irfxn-r/Active-Dampers/Master/jlcpcb/production_files/BOM-Active-Damper-Master.csv

Comment | Designator | Footprint | LCSC | Quantity
100k | R13,R3 | C_0603_1608Metric | C25803 | 2
100nF | C14,C19,C20 | C_0603_1608Metric | C14663 | 3
100pF | C54,C56,C57,C58 | C_0603_1608Metric | C14858 | 4
10k | R10 | R_0805_2012Metric | C17414 | 1
10nF | C9 | C_0603_1608Metric | C57112 | 1
10uF | C2,C21,C22 | C_0603_1608Metric | C96446 | 3
15uH | L1 | Inductor_7.3x6.6mm | C2045384 | 1
18k | R14,R8 | C_0603_1608Metric | C22967 | 2
1k | R23,R38 | R_0603_1608Metric | C21190 | 2
1uF | C1,C24,C25 | C_0603_1608Metric | C15849 | 3
2.2k | R12,R15 | C_0603_1608Metric | C4190 | 2
22nF | C4,C5,C6,C7,C8 | C_0603_1608Metric | C21122 | 5
22uF | C11,C12,C13,C15,C16,C17,C18 | C_0603_1608Metric | C59461 | 7
2k | R9 | R_0603_1608Metric | C22975 | 1
3.24k | R11 | R_0805_2012Metric | C26010 | 1
4.7k | R51,R54 | R_0603_1608Metric | C23162 | 2
5k1 | R6,R7 | R_0603_1608Metric | C23186 | 2
60 | R46,R47,R48,R49 | C_0603_1608Metric | C25196 | 4
68nF | C48,C49 | C_0603_1608Metric | C31658 | 2
AMS1117-3.3 | U3 | SOT-223-3_TabPin2 | C6186 | 1
ESP32-C6-WROOM-1-N8 | IC1 | ESP32C6WROOM1N8 | C5366877 | 1
LED BLUE | D7 | LED_0603_1608Metric | C2286 | 1
PESD1CAN | D6,D8 | SOT-23 | C15771 | 2
SS54 | D10,D2,D9 | D_SMA | C22452 | 3
SW_SPST | SW2,SW3 | SW_SPST_TS-1088-xR025 | C720477 | 2
TPS5430DDAR | U2 | ESOP-8_L4.9-W3.9-P1.27-LS6.0-TL-EP | C9864 | 1
USB_C_Receptacle_USB2.0_16P | J6 | USB_C_Receptacle_HRO_TYPE-C-31-M-12 | C165948 | 1
LSM6DSL | U6 | LGA-14_3x2.5mm_P0.5mm_LayoutBorder3x4y |  | 1
SN65HVD230 | U4 | SOIC-8_3.9x4.9mm_P1.27mm |  | 1
SN65HVD230 | U5 | SOIC-8_3.9x4.9mm_P1.27mm |  | 1
Conn_01x08 | J2 | JST_VH_B8P-VH-B_1x08_P3.96mm_Vertical |  | 1
