irfxn-r/Active-Dampers/Slave/jlcpcb/production_files/BOM-Active-Damper-Slave.csv

Comment | Designator | Footprint | LCSC | Quantity
0.1 | R4,R5 | C_2010_5025Metric_Pad1.52x2.65mm | C17903 | 2
100k | R3 | R_0402_1005Metric | C21190 | 1
100nF | C1,C14,C26 | C_0402_1005Metric | C14663 | 3
100pF | C57,C58,C59,C60 | C_0402_1005Metric | C14858 | 4
10k | R10,R2 | R_0402_1005Metric | C25744 | 2
10nF | C9 | C_0603_1608Metric | C57112 | 1
10uF | C10,C28 | C_0402_1005Metric | C15525 | 2
15uH | L1 | Inductor_7.3x6.6mm | C2045384 | 1
1k | R1 | R_0402_1005Metric | C11702 | 1
1uF | C19,C20,C21,C23,C24,C25,C27 | C_0402_1005Metric | C52923 | 7
2.2uF | C31 | C_0402_1005Metric | C12530 | 1
22nF | C22,C30,C4,C5,C6,C7,C8 | C_0603_1608Metric | C21122 | 7
22pF | C2,C29 | C_0402_1005Metric | C1555 | 2
22uF | C11,C12,C13,C15,C16,C17,C18 | C_0402_1005Metric | C59461 | 7
3.24k | R11 | R_0603_1608Metric | C22978 | 1
4.7k | R51,R53,R54 | R_0402_1005Metric | C25900 | 3
5k1 | R6,R7 | R_0603_1608Metric | C23186 | 2
60 | R48,R49,R52,R55 | C_0603_1608Metric | C23204 | 4
AMS1117-3.3 | U3 | SOT-223-3_TabPin2 | C6186 | 1
B5819WS | D5 | D_SOD-323 | C64886 | 1
LIS3DH | U4 | LGA-16_3x3mm_P0.5mm_LayoutBorder3x5y | C15134 | 1
PESD1CAN | D11,D8 | SOT-23 | C15771 | 2
SS54 | D2 | D_SMA | C22452 | 1
STM32F103C8T6 | U1 | LQFP-48_7x7mm_P0.5mm | C8734 | 1
SW_SPST | SW1 | SW_SPST_TS-1088-xR025 | C720477 | 1
TMC2209-LA | U5 | VQFN-28-1EP_5x5mm_P0.5mm_EP3.7x3.7mm_ThermalVias | C2150710 | 1
TPS5430DDAR | U2 | ESOP-8_L4.9-W3.9-P1.27-LS6.0-TL-EP | C9864 | 1
USB_C_Receptacle_USB2.0_16P | J6 | USB_C_Receptacle_HRO_TYPE-C-31-M-12 | C165948 | 1
X50328MSB2GI | X1 | CRYSTAL-SMD_L5.0-W3.2 | C115962 | 1
CAN_2 | J8 | JST_PH_S3B-PH-K_1x03_P2.00mm_Horizontal |  | 1
ATA6563-GBQW1 | IC4 | SON65P300X300X90-9N-D |  | 1
POWER | J7 | JST_PH_S3B-PH-K_1x03_P2.00mm_Horizontal |  | 1
ATA6563-GBQW1 | IC3 | SON65P300X300X90-9N-D |  | 1
CAN_1 | J9 | JST_PH_S3B-PH-K_1x03_P2.00mm_Horizontal |  | 1
AS5600-ASOM | IC2 | SOIC127P600X175-8N |  | 1
SHF-105-01-F-D-TH | J3 | SHF10501FDTH |  | 1
