irfxn-r/Active-Dampers/Slave/CAD/Slave.step

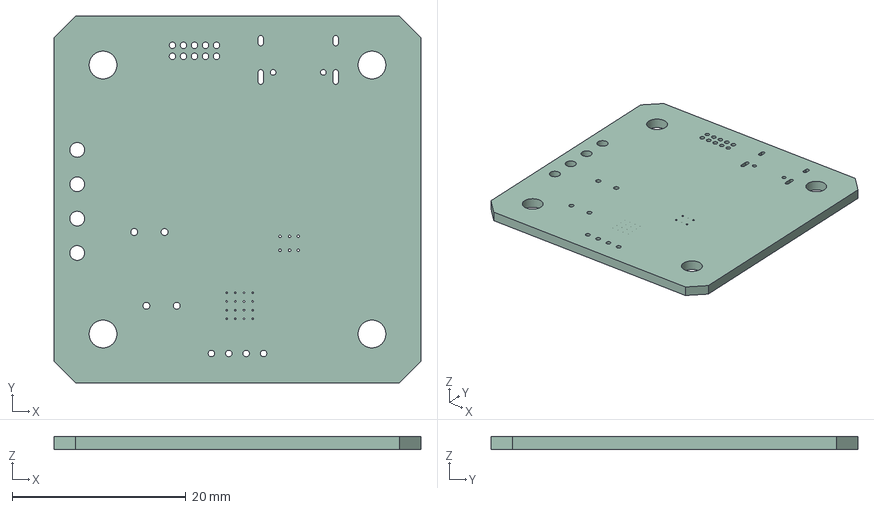
[picture p1: CAD file, 2026-09-19]
Slave/CAD/Slave.step
42.3 x 42.3 x 1.51 mm
