irfxn-r/Active-Dampers/(list of files, drawings)

Other design files:
Daughter/imu_daughter_board backup/sch_data.json
