irfxn-r/Active-Dampers/Master/Active-Damper-Master.kicad_pcb

## KiCad design Master/Active-Damper-Master.kicad_pcb (2026-09-27)

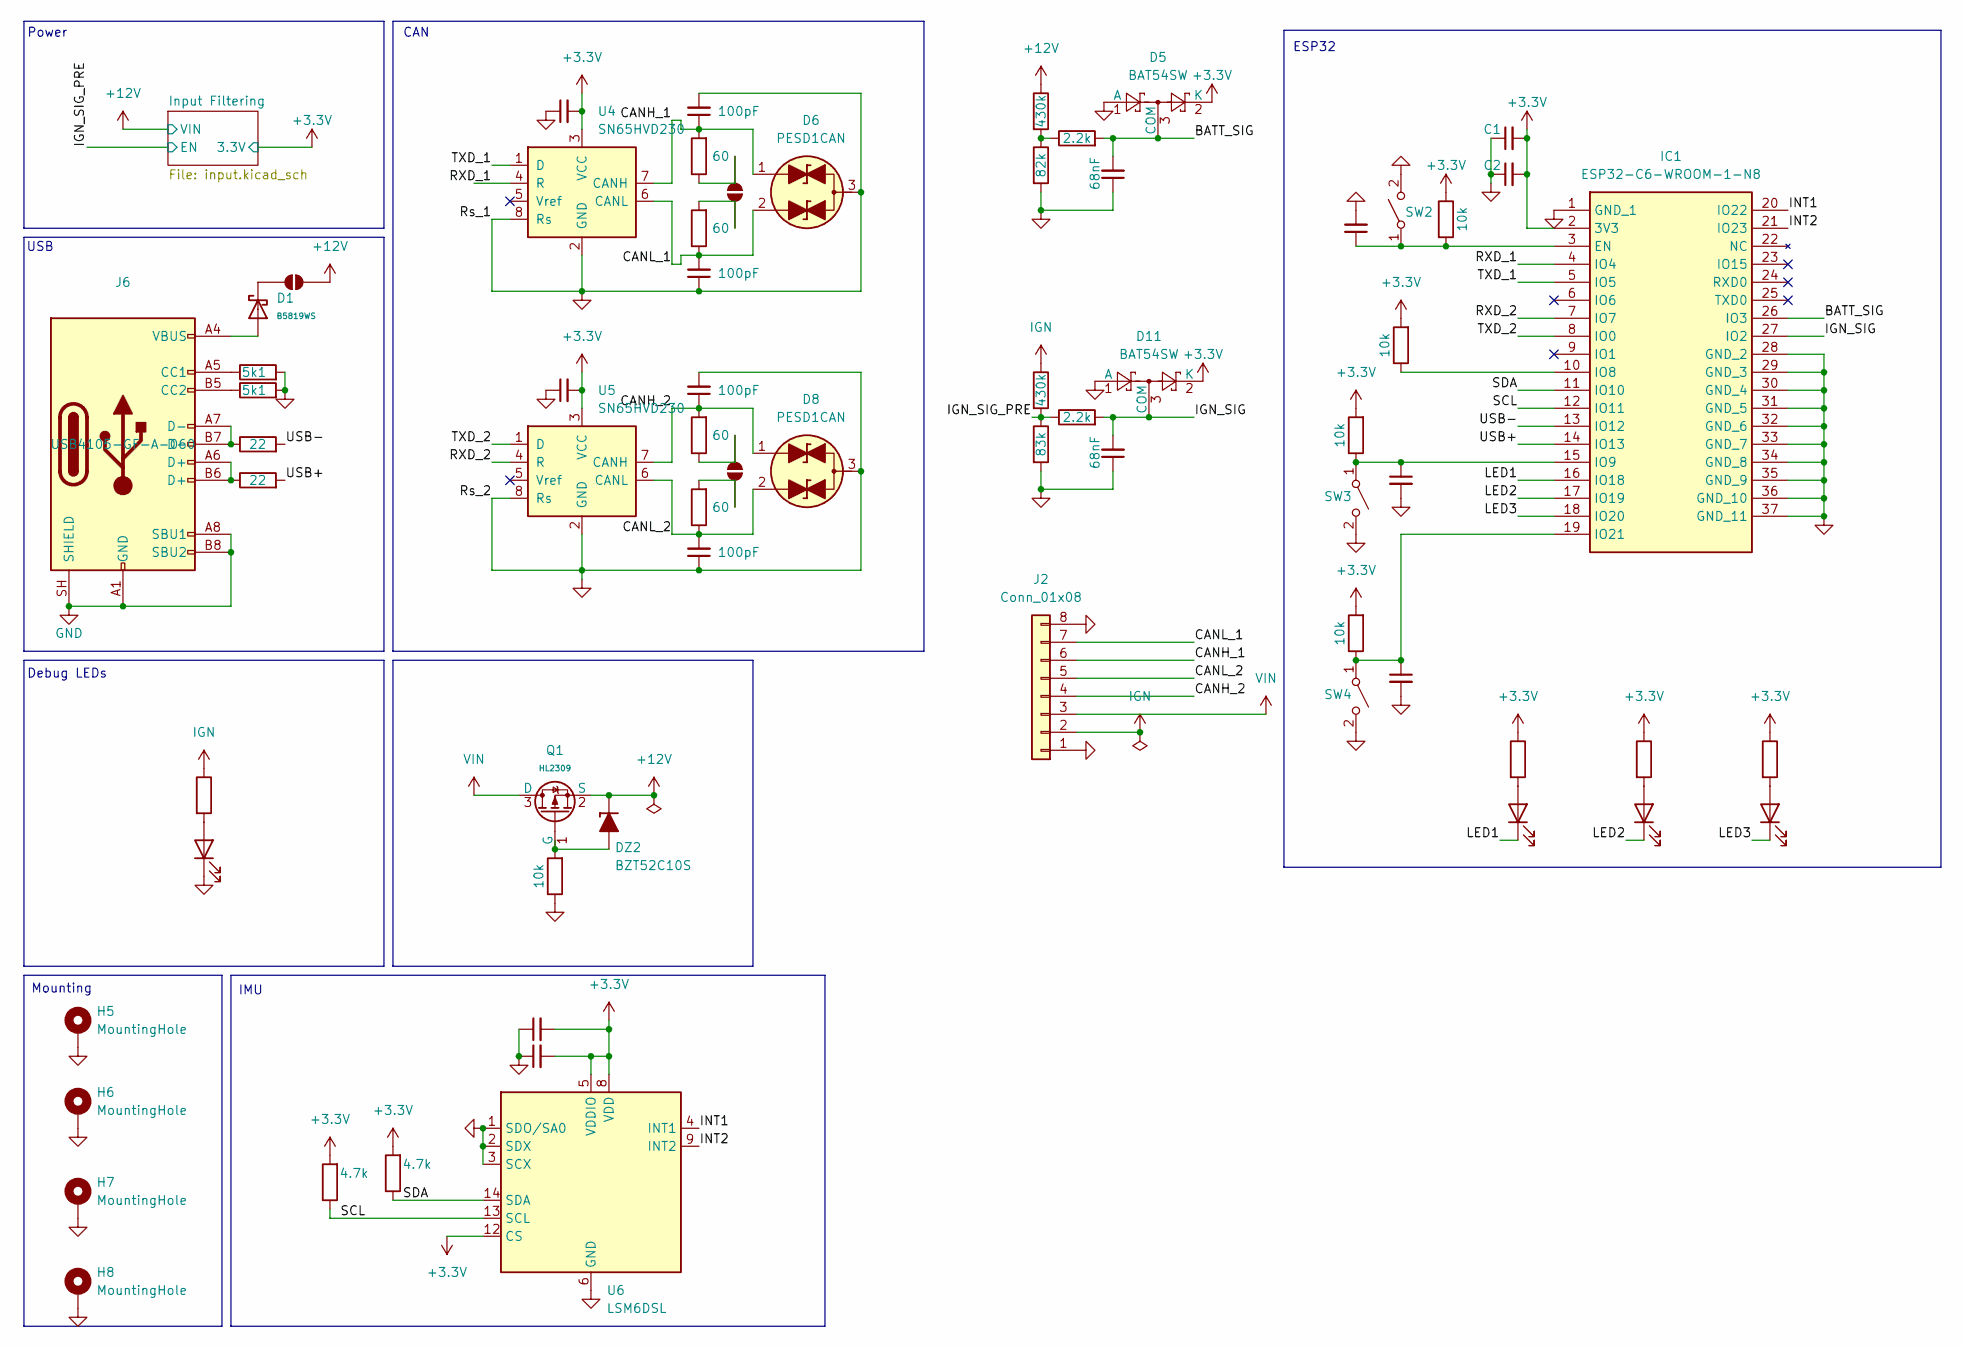
[picture p2: schematic Active-Damper-Master.kicad_sch]

Parts:
C1, C24, C25: 1uF; C_0603_1608Metric; Manufacturer_Part_Number TMK105BJ105MV-F; LCSC C15849
C2, C21, C26: 10uF; C_0603_1608Metric; Manufacturer_Part_Number CL05A106MP5NUNC; LCSC C96446
C19, C20: 100nF; C_0603_1608Metric; Manufacturer_Part_Number TMK105BJ105MV-F; LCSC C15849
C22: 1uF; C_0603_1608Metric; Manufacturer_Part_Number CL05A106MP5NUNC; LCSC C96446
C48, C49: 68nF; C_0603_1608Metric; Manufacturer_Part_Number CC0402KRX7R9BB683; LCSC C31658
C54, C56, C57, C58: 100pF; C_0603_1608Metric; LCSC C14858
D1: B5819WS; D_SOD-323; Forward Voltage (Vf@If) 900mV@3A; Reverse Voltage (Vr) 40V; Part B5819WS; LCSC C64886
D5, D11: BAT54SW; SOT-323_SC-70
D6, D8: PESD1CAN; SOT-23; LCSC C15771
D7, D9, D10, D12: LED BLUE; LED_0603_1608Metric; Manufacturer_Part_Number VLMB1500-GS08; LCSC C2286
DZ2: BZT52C10S; D_SOD-323
H5, H6, H7, H8: MountingHole; MountingHole_3.2mm_M3_ISO14580_Pad_TopBottom
IC1: ESP32-C6-WROOM-1-N8; ESP32C6WROOM1N8; Mouser Part Number 356-ESP32C6WROOM1N8
J2: Conn_01x08; JST_VH_B8P-VH-B_1x08_P3.96mm_Vertical
J6: USB_C_Receptacle_USB2.0_16P; USB_C_Receptacle_HRO_TYPE-C-31-M-12; Manufacturer_Part_Number USB4105-GF-A-060; LCSC C165948
JP2, JP4: SolderJumper_2_Open; SolderJumper-2_P1.3mm_Open_RoundedPad1.0x1.5mm
JP3: SolderJumper_2_Open; SolderJumper-2_P1.3mm_Open_Pad1.0x1.5mm
Q1: HL2309; SOT-23; Part HL2309; LCSC C28646263
R3, R13: 430k; C_0603_1608Metric; Manufacturer_Part_Number RC0402FR-07150KL; LCSC C25803
R6, R7: 5k1; R_0603_1608Metric; Manufacturer_Part_Number RC0402FR-071KL; LCSC C23186
R8: 82k; C_0603_1608Metric; Manufacturer_Part_Number AC0402JR-7D10KL; LCSC C22967
R9: 4..7k; R_0603_1608Metric; Manufacturer_Part_Number CR0402-FX-5101GLF; LCSC C22975
R12, R15: 2.2k; C_0603_1608Metric; Manufacturer_Part_Number RC0402FR-072K2L; LCSC C4190
R14: 83k; C_0603_1608Metric; Manufacturer_Part_Number AC0402JR-7D10KL; LCSC C22967
R16, R17, R18: 1k; R_0603_1608Metric; Manufacturer_Part_Number CR0402-FX-5101GLF; LCSC C22975
R19, R20: 22; R_0402_1005Metric; Manufacturer_Part_Number RC0402FR-071KL; LCSC C23186
R23, R38, R39, R40, R41: 10k; R_0603_1608Metric; Manufacturer_Part_Number RC0402FR-071KL; LCSC C21190
R46, R47, R48, R49: 60; C_0603_1608Metric; LCSC C25196
R51, R54: 4.7k; R_0603_1608Metric; LCSC C23162
SW2, SW3, SW4: SW_SPST; SW_SPST_TS-1088-xR025; LCSC C720477
U4, U5: SN65HVD230; SOIC-8_3.9x4.9mm_P1.27mm
U6: LSM6DSL; LGA-14_3x2.5mm_P0.5mm_LayoutBorder3x4y

Connections:
+3.3V: C1.2, C2.2, C19.2, C20.2, C24.2, C25.2, D5.2 (K), D11.2 (K), IC1.2 (3V3), R16.1, R17.1, R18.1, R23.1, R38.2, R40.2, R41.2, R51.2, R54.2, U4.3 (VCC), U5.3 (VCC), U6.5 (VDDIO), U6.8 (VDD), U6.12 (CS)
+12V: DZ2.1 (K), JP3.2 (B), Q1.2 (S), R3.1; also elsewhere on the board
/BATT_SIG: C48.2, D5.3 (COM), IC1.26 (IO3), R12.2
/CANH_1: C56.1, D6.1 (A1), J2.6, R46.2, U4.7 (CANH)
/CANH_2: C57.1, D8.1 (A1), J2.4, R48.2, U5.7 (CANH)
/CANL_1: C54.2, D6.2 (A2), J2.7, R47.1, U4.6 (CANL)
/CANL_2: C58.2, D8.2 (A2), J2.5, R49.1, U5.6 (CANL)
/IGN_SIG: C49.2, D11.3 (COM), IC1.27 (IO2), R15.2
/IGN_SIG_PRE: R13.2, R14.1, R15.1; also elsewhere on the board
/INT1: IC1.20 (IO22), U6.4 (INT1)
/INT2: IC1.21 (IO23), U6.9 (INT2)
/LED1: D9.1 (K), IC1.16 (IO18)
/LED2: D10.1 (K), IC1.17 (IO19)
/LED3: D12.1 (K), IC1.18 (IO20)
/RXD_1: IC1.4 (IO4), U4.4 (R)
/RXD_2: IC1.7 (IO7), U5.4 (R)
/SCL: IC1.12 (IO11), R54.1, U6.13 (SCL)
/SDA: IC1.11 (IO10), R51.1, U6.14 (SDA)
/TXD_1: IC1.5 (IO5), U4.1 (D)
/TXD_2: IC1.8 (IO0), U5.1 (D)
/USB+: IC1.14 (IO13), R20.2
/USB-: IC1.13 (IO12), R19.2
GND: C1.1, C2.1, C19.1, C20.1, C21.2, C22.2, C24.1, C25.1, C26.2, C48.1, C49.1, C54.1, C56.2, C57.2, C58.1, D5.1 (A), D6.3 (Com), D7.1 (K), D8.3 (Com), D11.1 (A), H5.1 (1_1), H6.1 (1_1), H7.1 (1_1), H8.1 (1_1), IC1.1 (GND_1), IC1.28 (GND_2), IC1.29 (GND_3), IC1.30 (GND_4), IC1.31 (GND_5), IC1.32 (GND_6), IC1.33 (GND_7), IC1.34 (GND_8), IC1.35 (GND_9), IC1.36 (GND_10), IC1.37 (GND_11), J2.1, J2.8, J6.A1 (GND), J6.A8 (SBU1), J6.A12 (GND), J6.B1 (GND), J6.B8 (SBU2), J6.B12 (GND), J6.SH (SHIELD), R6.2, R7.2, R8.2, R14.2, R39.1, SW2.2 (B), SW3.2 (B), SW4.2 (B), U4.2 (GND), U4.8 (Rs), U5.2 (GND), U5.8 (Rs), U6.1 (SDO/SA0), U6.2 (SDX), U6.3 (SCX), U6.6 (GND), U6.7 (GND); also elsewhere on the board
IGN: J2.2, R9.1, R13.1
unnamed: D1.2, J6.A4 (VBUS), J6.A9 (VBUS), J6.B4 (VBUS), J6.B9 (VBUS)
unnamed: D7.2 (A), R9.2
unnamed: D9.2 (A), R16.2
unnamed: D10.2 (A), R17.2
unnamed: D12.2 (A), R18.2
unnamed: DZ2.2 (A), Q1.1 (G), R39.2
unnamed: C22.1, IC1.3 (EN), R23.2, SW2.1 (A)
unnamed: IC1.10 (IO8), R41.1
unnamed: C21.1, IC1.15 (IO9), R38.1, SW3.1 (A)
unnamed: C26.1, IC1.19 (IO21), R40.1, SW4.1 (A)
unnamed: J6.A5 (CC1), R6.1
unnamed: J6.B5 (CC2), R7.1
unnamed: J6.A6 (D+), J6.B6 (D+), R20.1
unnamed: J6.A7 (D-), J6.B7 (D-), R19.1
unnamed: JP2.1 (A), R49.2
unnamed: JP2.2 (B), R48.1
unnamed: D1.1, JP3.1 (A)
unnamed: JP4.1 (A), R47.2
unnamed: JP4.2 (B), R46.1
unnamed: R3.2, R8.1, R12.1
VIN: J2.3, Q1.3 (D)

Notes on the sheet:
ESP32
IMU
CAN
Power
USB
Debug LEDs
Mounting

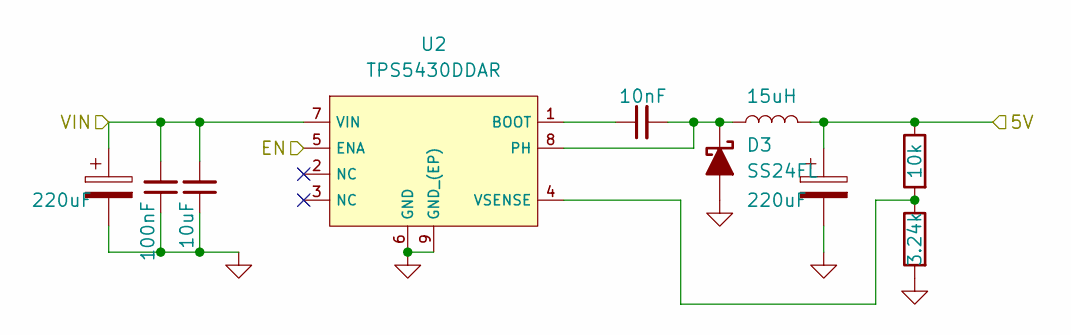
[picture p3: schematic input.kicad_sch]

Parts:
C3, C10: 220uF; CP_Radial_D8.0mm_P3.50mm
C9: 10nF; C_0603_1608Metric; Manufacturer_Part_Number GRM155R60J226ME11D; LCSC C57112
C34: 100nF; C_0603_1608Metric; Manufacturer_Part_Number CL05A106MP5NUNC; LCSC C21122
C35: 10uF; C_0603_1608Metric; Manufacturer_Part_Number CL05A106MP5NUNC; LCSC C21122
D3: SS24FL; D_SOD-123F
L1: 15uH; L_Taiyo-Yuden_NR-40xx; Manufacturer_Part_Number SLO0630H150MTT; LCSC C2045384
R21: 10k; R_0603_1608Metric; Manufacturer_Part_Number RC0402FR-0710KL; LCSC C25804
R22: 3.24k; R_0603_1608Metric; Manufacturer_Part_Number RC0402FR-0710KL; LCSC C22978
U2: TPS5430DDAR; ESOP-8_L4.9-W3.9-P1.27-LS6.0-TL-EP; Output Voltage 1.221V~32.04V; Input Voltage 5.5V~36V; Part TPS5430DDAR; LCSC C9864

Connections:
+12V: C3.1, C34.2, C35.2, U2.7 (VIN); also elsewhere on the board
/IGN_SIG_PRE: U2.5 (ENA); also elsewhere on the board
/Input Filtering/5V: C10.1, L1.2, R21.2
GND: C3.2, C10.2, C34.1, C35.1, D3.2 (A), R22.1, U2.6 (GND), U2.9 (GND_(EP)); also elsewhere on the board
unnamed: C9.2, D3.1 (K), L1.1, U2.8 (PH)
unnamed: C9.1, U2.1 (BOOT)
unnamed: R21.1, R22.2, U2.4 (VSENSE)

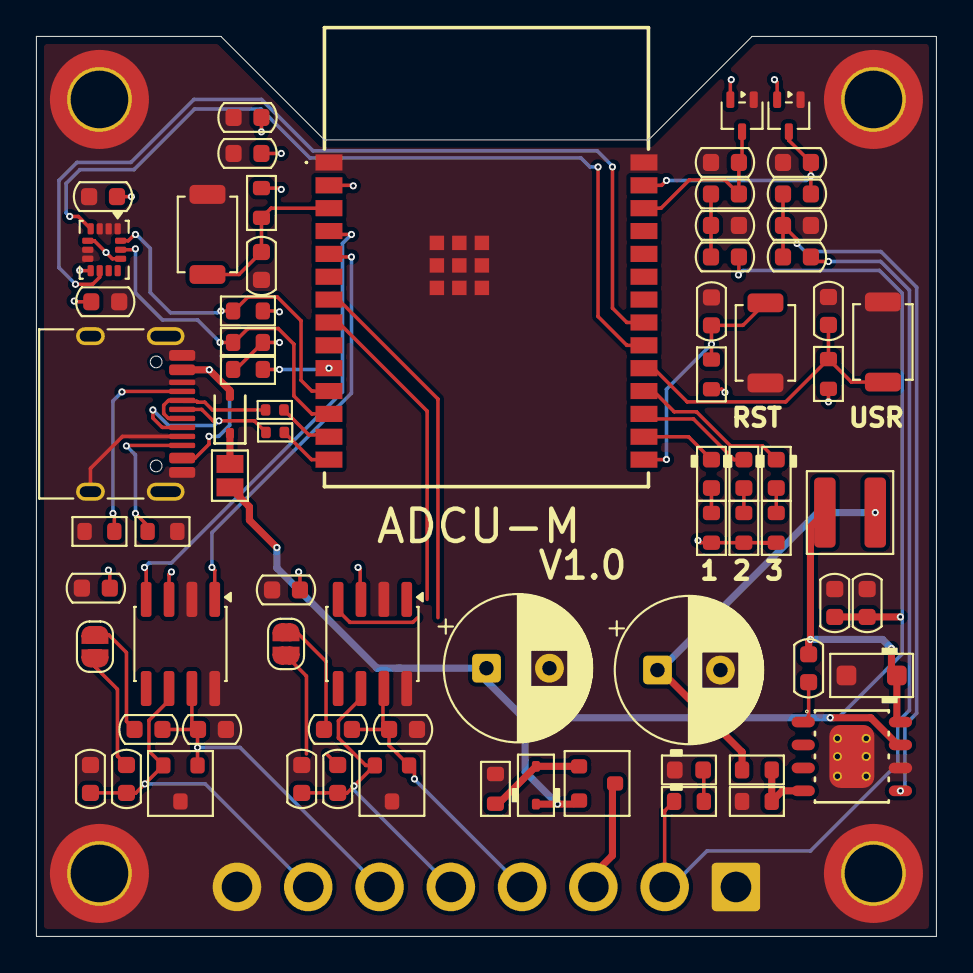
[picture p4: board Active-Damper-Master.kicad_pcb from above]

Board: 2 copper layers, 50.0 x 50.0 mm, 77 parts (1 on the bottom side), 49 nets.
