irfxn-r/Active-Dampers/Slave/Active-Damper-Slave.kicad_pcb

## KiCad design Slave/Active-Damper-Slave.kicad_pcb (2026-09-27)

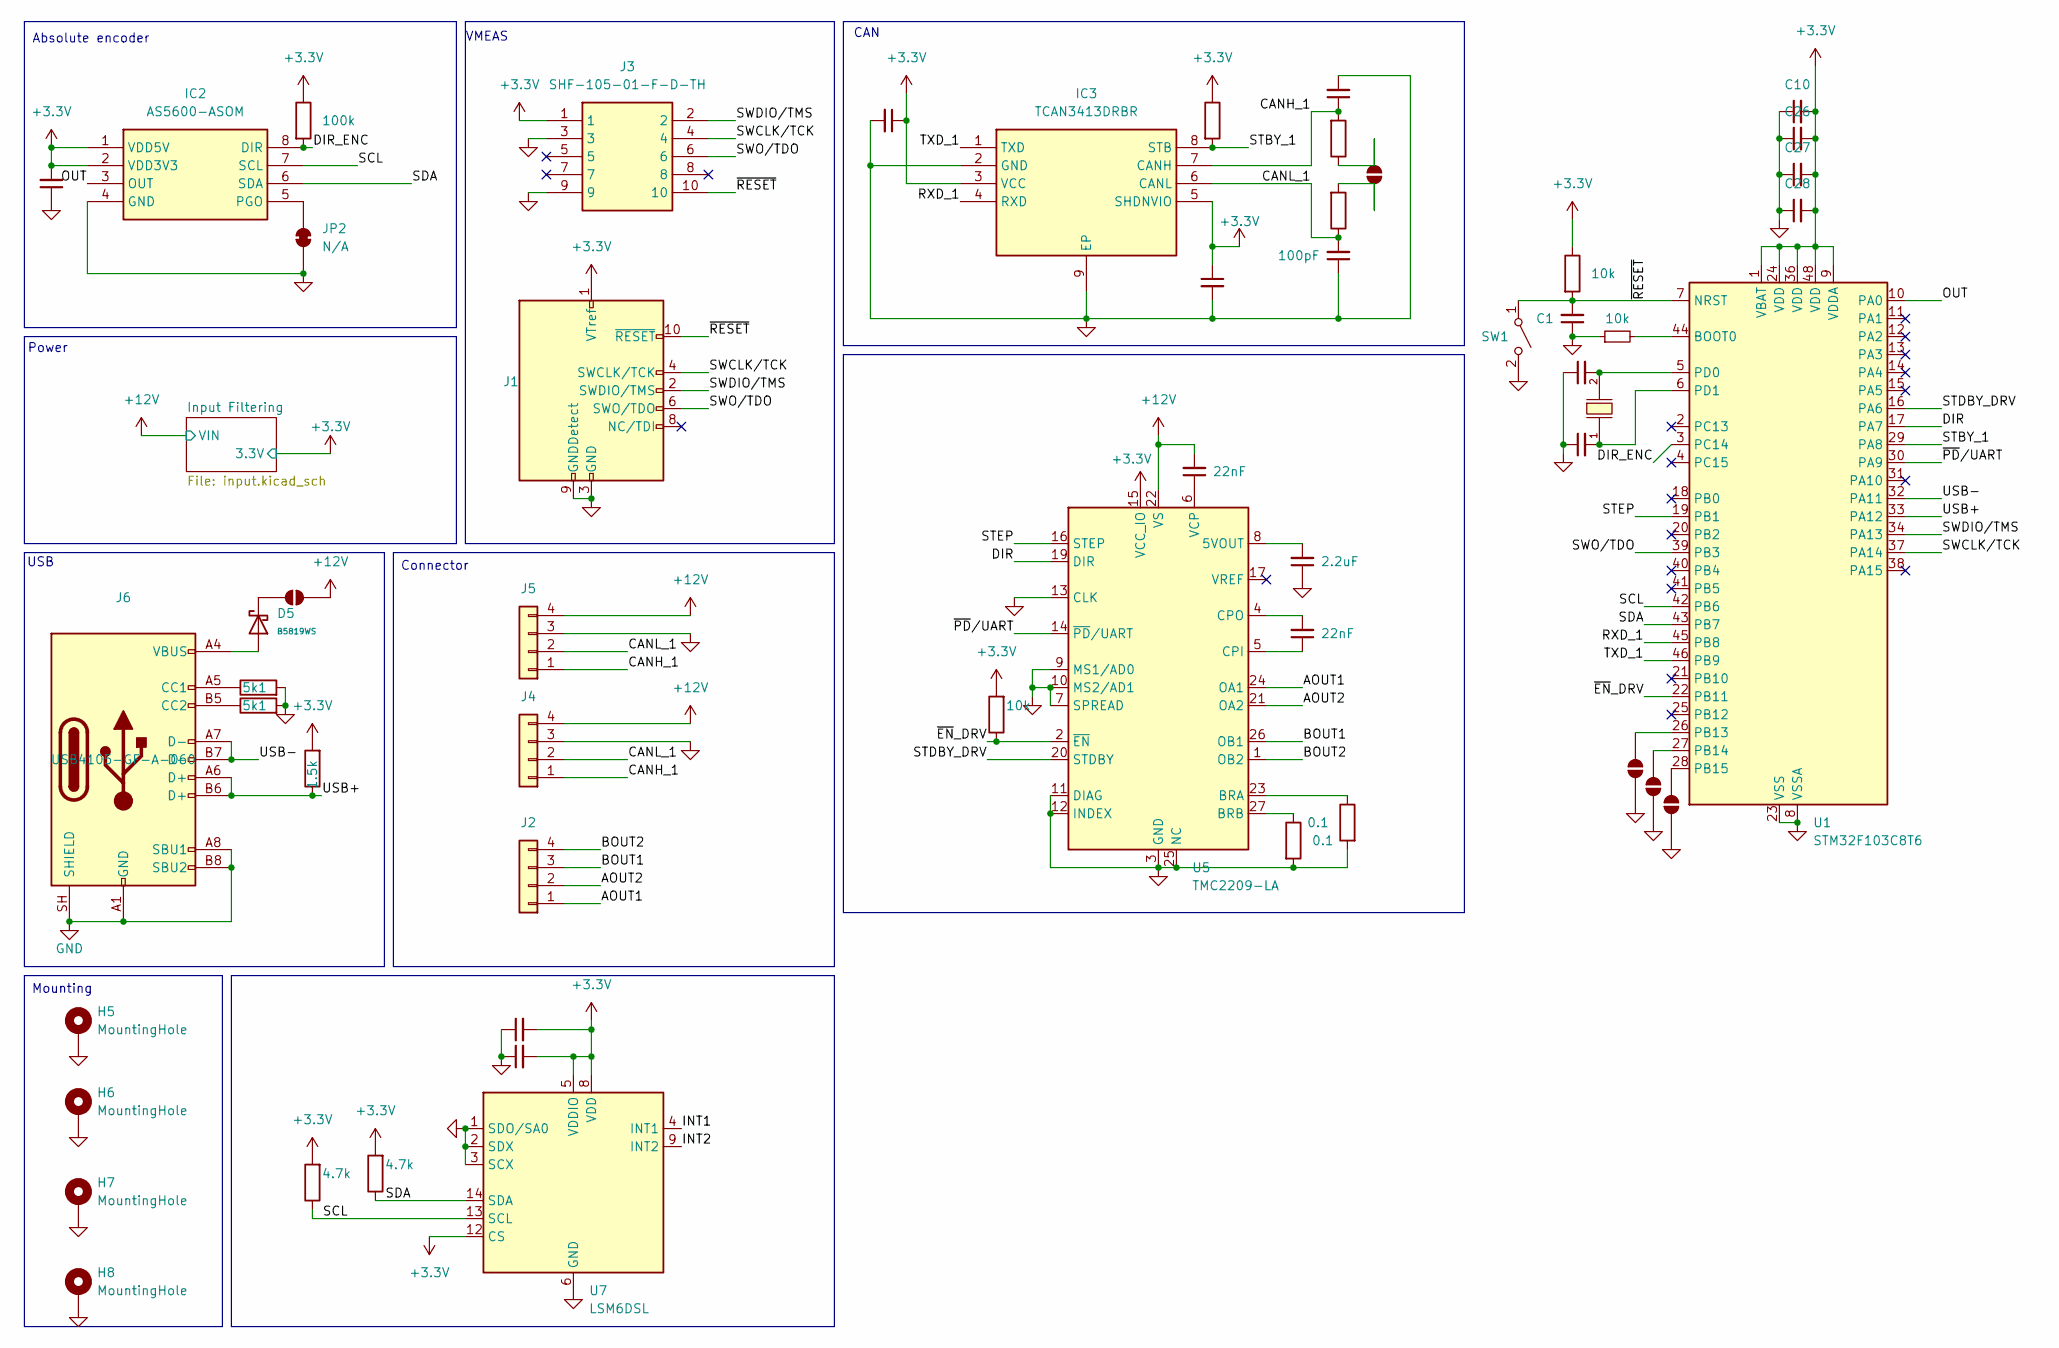
[picture p5: schematic Active-Damper-Slave.kicad_sch]

Parts:
C1, C26: 100nF; C_0402_1005Metric; Manufacturer_Part_Number MCASU105SB5104MFNA01; LCSC C14663
C2, C29: 22pF; C_0402_1005Metric; Manufacturer_Part_Number MCASU105SB5104MFNA01; LCSC C1653
C10, C28: 10uF; C_0402_1005Metric; Manufacturer_Part_Number CL05A106MP5NUNC; LCSC C96446
C20, C24, C25, C27: 1uF; C_0402_1005Metric; Manufacturer_Part_Number TMK105BJ105MV-F; LCSC C15849
C22, C30: 22nF; C_0603_1608Metric; Manufacturer_Part_Number CL05A106MP5NUNC; LCSC C23630
C31: 2.2uF; C_0402_1005Metric; Manufacturer_Part_Number CL05A106MP5NUNC; LCSC C23630
C39, C40: 100nF; C_0402_1005Metric; Manufacturer_Part_Number TMK105BJ105MV-F; LCSC C15849
C59, C60: 100pF; C_0402_1005Metric; LCSC C14858
D5: B5819WS; D_SOD-323; Forward Voltage (Vf@If) 900mV@3A; Reverse Voltage (Vr) 40V; Part B5819WS; LCSC C64886
H5, H6, H7, H8: MountingHole; MountingHole_3.2mm_M3_ISO14580_Pad_TopBottom
IC2: AS5600-ASOM; SOIC127P600X175-8N; Mouser Part Number 985-AS5600-ASOM
IC3: TCAN3413DRBR; SON65P300X300X100-9N-D; Mouser Part Number 595-TCAN3413DRBR
J1: Conn_ARM_JTAG_SWD_10; SHF10501FDTH
J2, J4, J5: FL; SolderWire-0.5sqmm_1x04_P4.6mm_D0.9mm_OD2.1mm
J3: SHF-105-01-F-D-TH; SHF10501FDTH; Mouser Part Number 200-SHF10501FDTH
J6: USB_C_Receptacle_USB2.0_16P; USB_C_Receptacle_HRO_TYPE-C-31-M-12; Manufacturer_Part_Number USB4105-GF-A-060; LCSC C165948
JP1, JP5, JP6: SolderJumper_2_Open; SolderJumper-2_P1.3mm_Open_RoundedPad1.0x1.5mm
JP2: SolderJumper_2_Bridged; SolderJumper-2_P1.3mm_Bridged_Pad1.0x1.5mm; Manufacturer_Part_Number N/A
JP3, JP4: SolderJumper_2_Open; SolderJumper-2_P1.3mm_Open_Pad1.0x1.5mm
R1: 10k; R_0402_1005Metric; Manufacturer_Part_Number RC0402FR-071KL; LCSC C21190
R2: 10k; R_0402_1005Metric; Manufacturer_Part_Number AC0402FR-7D100KL; LCSC C25804
R4, R5: 0.1; R_2010_5025Metric; Manufacturer_Part_Number RC0402FR-071KL; LCSC C21190
R6, R7: 5k1; R_0603_1608Metric; Manufacturer_Part_Number RC0402FR-071KL; LCSC C23186
R10, R12: 100k; R_0402_1005Metric; Manufacturer_Part_Number RC0402FR-071KL; LCSC C21190
R11: 1.5k; R_0603_1608Metric; Manufacturer_Part_Number RC0402FR-071KL; LCSC C23186
R52, R55: 60; C_0603_1608Metric; LCSC C25196
R56, R57: 4.7k; R_0402_1005Metric; LCSC C23162
R58: 10k; R_0402_1005Metric; LCSC C23162
SW1: SW_SPST; SW_SPST_TS-1088-xR025; LCSC C720477
U1: STM32F103C8T6; LQFP-48_7x7mm_P0.5mm; Operating Voltage Range 2V~3.6V; Low Voltage Detection T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 2V~3.6V; Part STM32F103C8T6; LCSC C8734
U5: TMC2209-LA; VQFN-28-1EP_5x5mm_P0.5mm_EP3.7x3.7mm_ThermalVias; LCSC C2150710
U7: LSM6DSL; LGA-14_3x2.5mm_P0.5mm_LayoutBorder3x4y
ye1: X50328MSB2GI; CRYSTAL-SMD_L5.0-W3.2; Frequency Tolerance ±10ppm; Part X50328MSB2GI; LCSC C115962

Connections:
+3.3V: C10.2, C20.2, C24.1, C25.1, C26.2, C27.2, C28.2, C39.2, C40.2, IC2.1 (VDD5V), IC2.2 (VDD3V3), IC3.3 (VCC), IC3.5 (SHDNVIO), J1.1 (VTref), J3.1, R1.1, R10.1, R11.2, R12.1, R56.2, R57.2, R58.2, U1.1 (VBAT), U1.9 (VDDA), U1.24 (VDD), U1.36 (VDD), U1.48 (VDD), U5.15 (VCC_IO), U7.5 (VDDIO), U7.8 (VDD), U7.12 (CS); also elsewhere on the board
+12V: C30.2, J4.4, J5.4, JP3.2 (B), U5.22 (VS), U5.28 (VS); also elsewhere on the board
/AOUT1: J2.1, U5.24 (OA1)
/AOUT2: J2.2, U5.21 (OA2)
/BOUT1: J2.3, U5.26 (OB1)
/BOUT2: J2.4, U5.1 (OB2)
/CANH_1: C59.1, IC3.7 (CANH), J4.1, J5.1, R52.2
/CANL_1: C60.2, IC3.6 (CANL), J4.2, J5.2, R55.1
/DIR: U1.17 (PA7), U5.19 (DIR)
/DIR_ENC: IC2.8 (DIR), R12.2, U1.3 (PC14)
/INT1: U7.4 (INT1)
/INT2: U7.9 (INT2)
/OUT: IC2.3 (OUT), U1.10 (PA0)
/RXD_1: IC3.4 (RXD), U1.45 (PB8)
/SCL: IC2.7 (SCL), R56.1, U1.42 (PB6), U7.13 (SCL)
/SDA: IC2.6 (SDA), R57.1, U1.43 (PB7), U7.14 (SDA)
/STBY_1: IC3.8 (STB), R10.2, U1.29 (PA8)
/STDBY_DRV: U1.16 (PA6), U5.20 (STDBY)
/STEP: U1.19 (PB1), U5.16 (STEP)
/SWCLK/TCK: J1.4 (SWCLK/TCK), J3.4, U1.37 (PA14)
/SWDIO/TMS: J1.2 (SWDIO/TMS), J3.2, U1.34 (PA13)
/SWO/TDO: J1.6 (SWO/TDO), J3.6, U1.39 (PB3)
/TXD_1: IC3.1 (TXD), U1.46 (PB9)
/USB+: J6.A6 (D+), J6.B6 (D+), R11.1, U1.33 (PA12)
/USB-: J6.A7 (D-), J6.B7 (D-), U1.32 (PA11)
/~EN_DRV: R58.1, U1.22 (PB11), U5.2 (~EN)
/~PD/UART: U1.30 (PA9), U5.14 (~PD/UART)
/~RESET: C1.2, J1.10 (~RESET), J3.10, R1.2, SW1.1 (A), U1.7 (NRST)
GND: C1.1, C2.1, C10.1, C20.1, C24.2, C25.2, C26.1, C27.1, C28.1, C29.1, C31.1, C39.1, C40.1, C59.2, C60.1, H5.1 (1_1), H6.1 (1_1), H7.1 (1_1), H8.1 (1_1), IC2.4 (GND), IC3.2 (GND), IC3.9 (EP), J1.3 (GND), J1.5 (GND), J1.9 (GNDDetect), J3.3, J3.9, J4.3, J5.3, J6.A1 (GND), J6.A8 (SBU1), J6.A12 (GND), J6.B1 (GND), J6.B8 (SBU2), J6.B12 (GND), J6.SH (SHIELD), JP1.1 (A), JP2.1 (A), JP5.1 (A), JP6.1 (A), R2.1, R4.2, R5.2, R6.2, R7.2, SW1.2 (B), U1.8 (VSSA), U1.23 (VSS), U1.35 (VSS), U1.47 (VSS), U5.3 (GND), U5.7 (SPREAD), U5.9 (MS1/AD0), U5.10 (MS2/AD1), U5.11 (DIAG), U5.12 (INDEX), U5.13 (CLK), U5.18 (GND), U5.25 (NC), U5.29 (GND), U7.1 (SDO/SA0), U7.2 (SDX), U7.3 (SCX), U7.6 (GND), U7.7 (GND); also elsewhere on the board
unnamed: D5.2, J6.A4 (VBUS), J6.A9 (VBUS), J6.B4 (VBUS), J6.B9 (VBUS)
unnamed: IC2.5 (PGO), JP2.2 (B)
unnamed: J6.A5 (CC1), R6.1
unnamed: J6.B5 (CC2), R7.1
unnamed: JP1.2 (B), U1.26 (PB13)
unnamed: D5.1, JP3.1 (A)
unnamed: JP4.1 (A), R55.2
unnamed: JP4.2 (B), R52.1
unnamed: JP5.2 (B), U1.27 (PB14)
unnamed: JP6.2 (B), U1.28 (PB15)
unnamed: R2.2, U1.44 (BOOT0)
unnamed: C2.2, U1.5 (PD0), ye1.2
unnamed: C29.2, U1.6 (PD1), ye1.1
unnamed: C31.2, U5.8 (5VOUT)
unnamed: R5.1, U5.23 (BRA)
unnamed: R4.1, U5.27 (BRB)
unnamed: C22.1, U5.5 (CPI)
unnamed: C22.2, U5.4 (CPO)
unnamed: C30.1, U5.6 (VCP)

Notes on the sheet:
Power
Connector
VMEAS
Absolute encoder
CAN
USB
Mounting

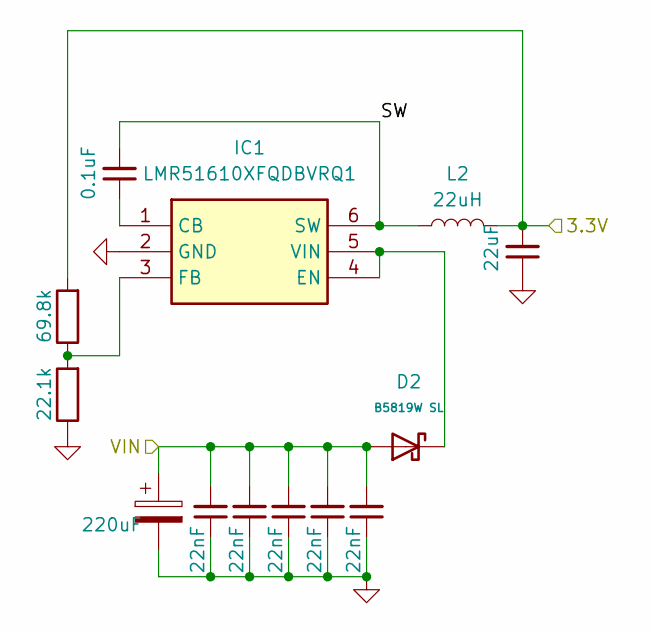
[picture p6: schematic input.kicad_sch]

Parts:
C21: 220uF; CP_Radial_D8.0mm_P3.50mm
C23, C32, C33, C34, C35: 22nF; C_0603_1608Metric; Manufacturer_Part_Number CL05A106MP5NUNC; LCSC C21122
C41: 0.1uF; C_0603_1608Metric; Manufacturer_Part_Number CL05A106MP5NUNC; LCSC C21122
C42: 22uF; C_0603_1608Metric; Manufacturer_Part_Number CL05A106MP5NUNC; LCSC C21122
D2: B5819W SL; D_SOD-123; Forward Voltage (Vf@If) 600mV@1A; Reverse Voltage (Vr) 40V; Part B5819W SL; LCSC C8598
IC1: LMR51610XFQDBVRQ1; SOT95P280X145-6N; Mouser Part Number 595-LMR51610XFQDBRQ1
L2: 22uH; L_Taiyo-Yuden_MD-4040
R8: 69.8k; R_0603_1608Metric; Manufacturer_Part_Number RC0402FR-071KL; LCSC C23186
R9: 22.1k; R_0603_1608Metric; Manufacturer_Part_Number RC0402FR-071KL; LCSC C23186

Connections:
+3.3V: C42.2, L2.2, R8.2; also elsewhere on the board
+12V: C21.1, C23.2, C32.2, C33.2, C34.2, C35.2, D2.2; also elsewhere on the board
/Input Filtering/SW: C41.2, IC1.6 (SW), L2.1
GND: C21.2, C23.1, C32.1, C33.1, C34.1, C35.1, C42.1, IC1.2 (GND), R9.1; also elsewhere on the board
unnamed: C41.1, IC1.1 (CB)
unnamed: D2.1, IC1.4 (EN), IC1.5 (VIN)
unnamed: IC1.3 (FB), R8.1, R9.2

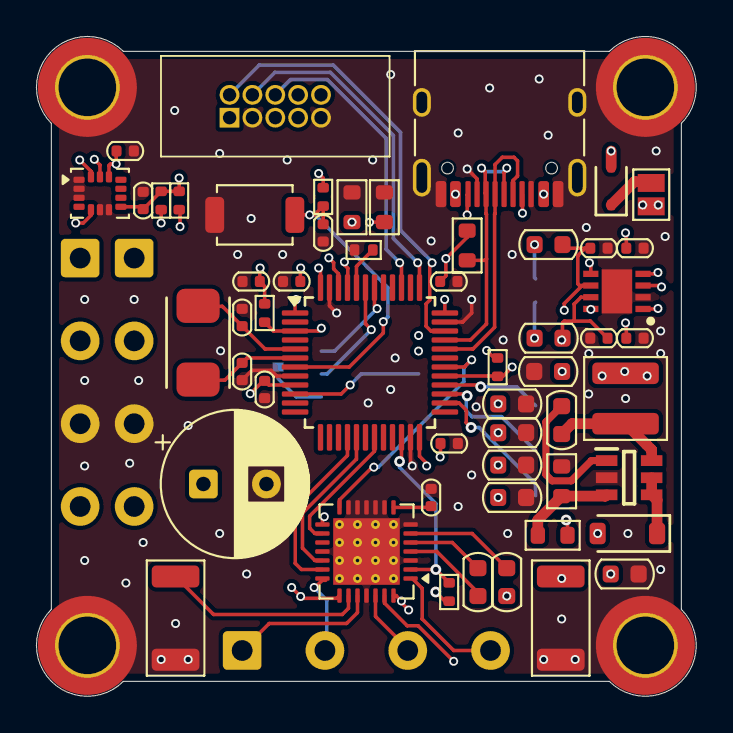
[picture p7: board Active-Damper-Slave.kicad_pcb from above]

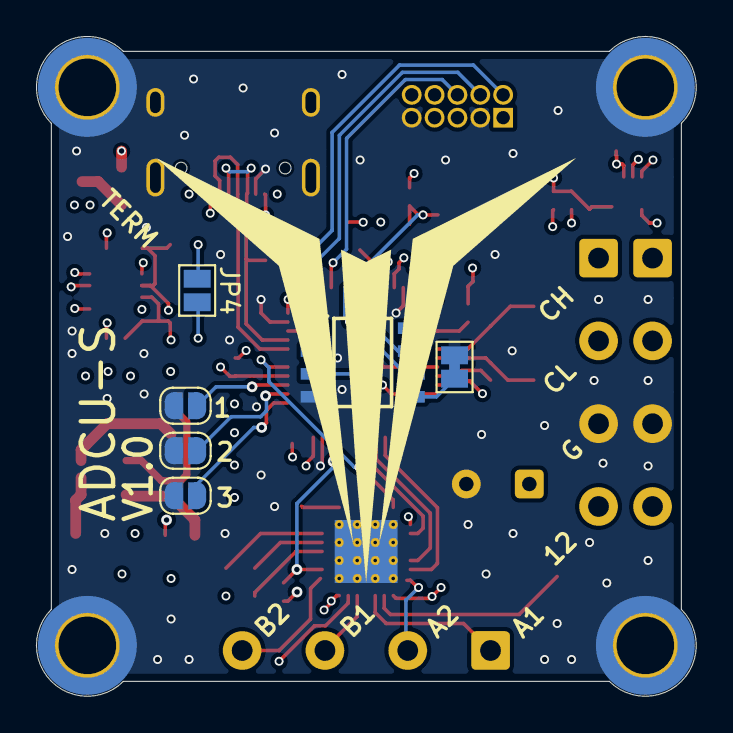
[picture p8: board Active-Damper-Slave.kicad_pcb from below]

Board: 4 copper layers, 36.7 x 36.7 mm, 67 parts (6 on the bottom side), 50 nets.
