irfxn-r/Active-Dampers/Combined/Active-Dampers.kicad_pcb

## KiCad design Combined/Active-Dampers.kicad_pcb (2026-01-19)

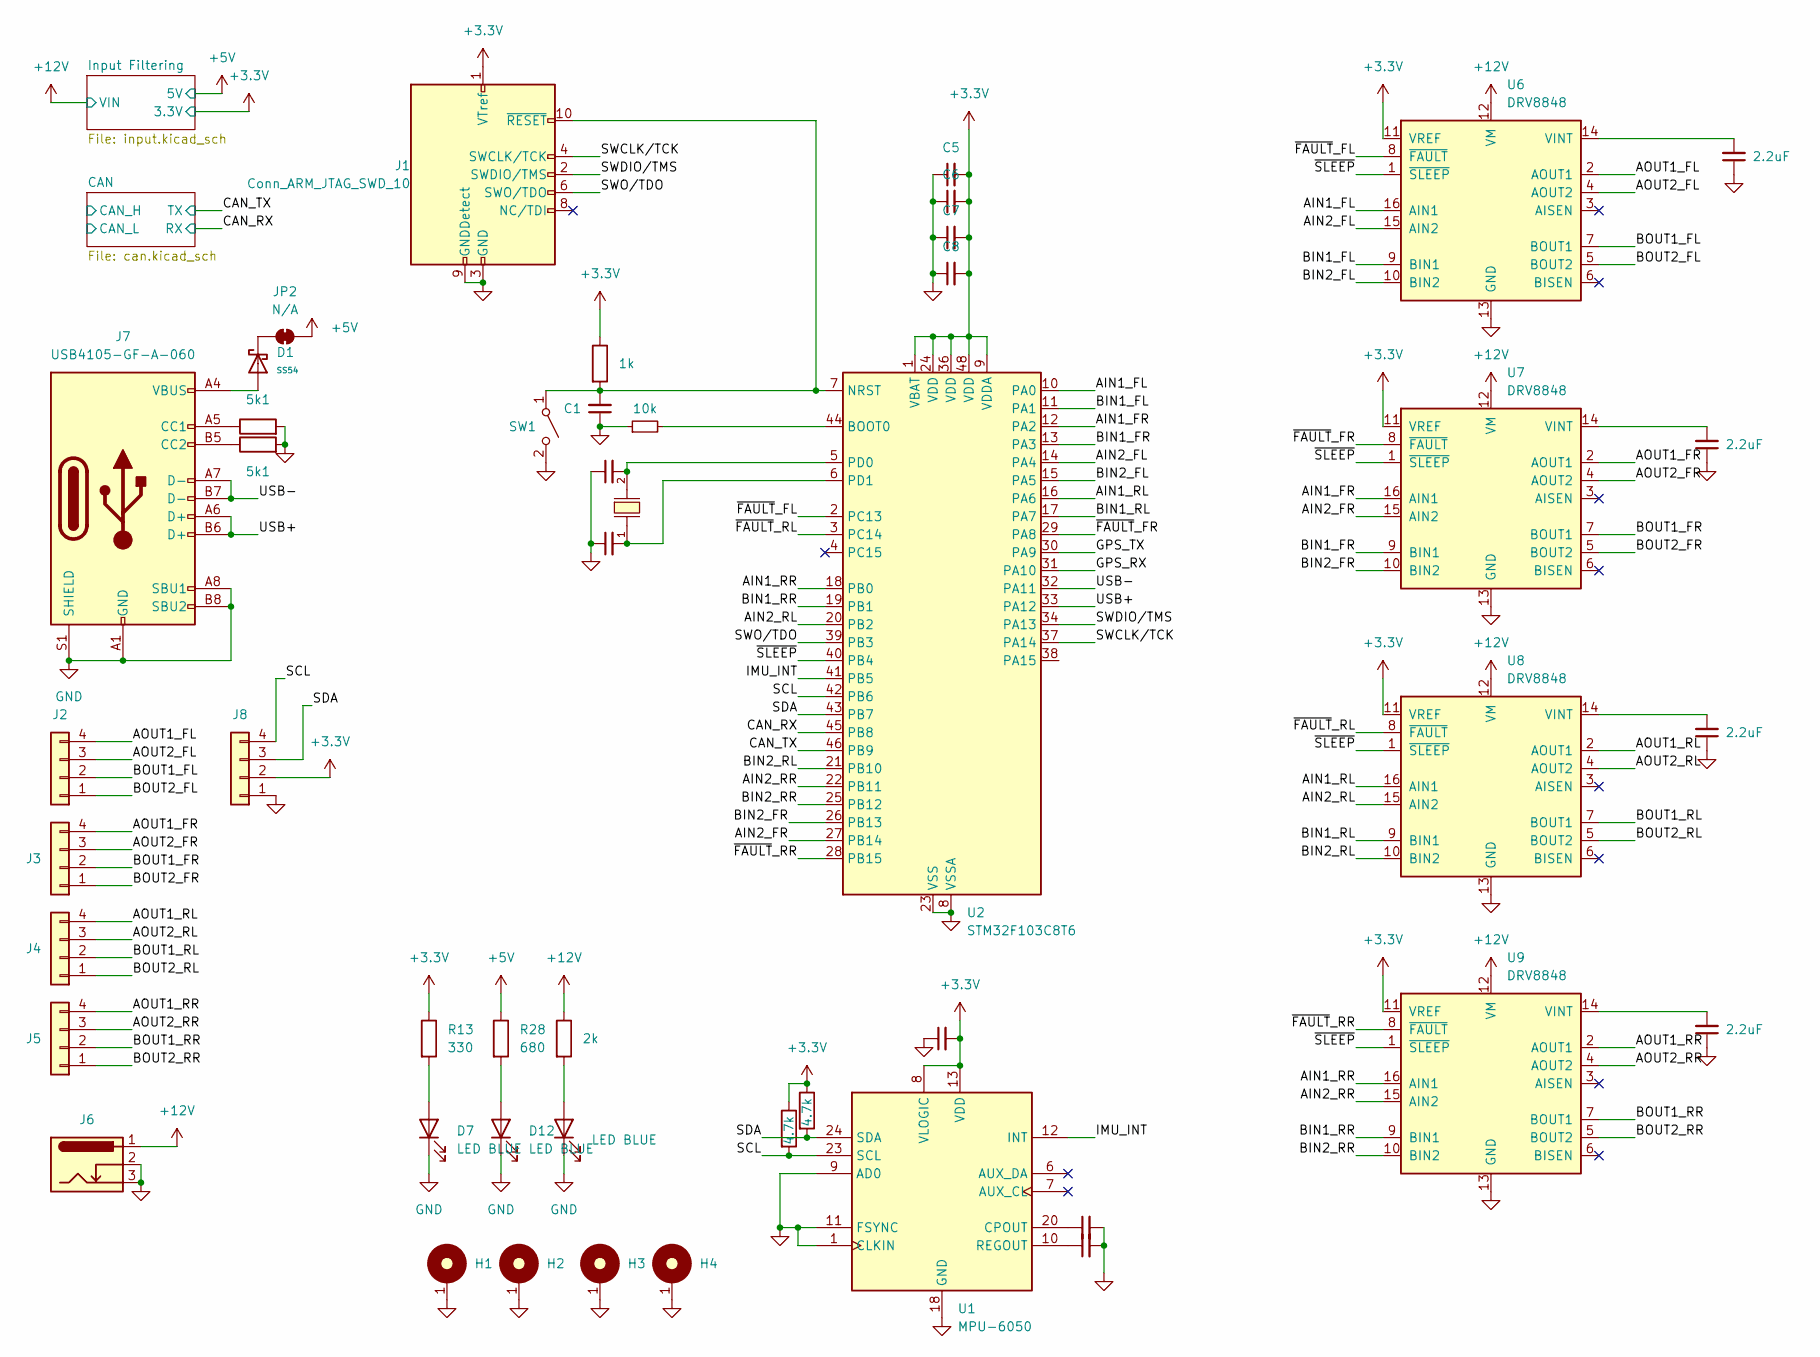
[picture p9: schematic Active-Dampers.kicad_sch]

Parts:
C1, C6: 100nF; C_0603_1608Metric; Manufacturer_Part_Number MCASU105SB5104MFNA01; LCSC C14663
C2, C3: 22pF; C_0603_1608Metric; Manufacturer_Part_Number MCASU105SB5104MFNA01; LCSC C1653
C5, C8, C9: 10uF; C_0603_1608Metric; Manufacturer_Part_Number CL05A106MP5NUNC; LCSC C96446
C7: 1uF; C_0603_1608Metric; Manufacturer_Part_Number TMK105BJ105MV-F; LCSC C15849
C10: 2.2nF; C_0603_1608Metric; Manufacturer_Part_Number CL05A106MP5NUNC; LCSC C1604
C11, C12, C13, C14: 2.2uF; C_0603_1608Metric; Manufacturer_Part_Number CL05A106MP5NUNC; LCSC C23630
C34: 0.1uF; C_0603_1608Metric; Manufacturer_Part_Number CL05A106MP5NUNC; LCSC C14663
D1: SS54; D_SMA; Forward Voltage (Vf@If) 550mV@5A; Reverse Voltage (Vr) 40V; Part SS54; LCSC C22452
D7, D12, D14: LED BLUE; LED_0603_1608Metric; Manufacturer_Part_Number VLMB1500-GS08; LCSC C2286
H1, H2, H3, H4: MountingHole_M3_3.2mm_Pad; MountingHole_2.2mm_M2_ISO14580_Pad
J1: Conn_ARM_JTAG_SWD_10; 62701021621
J2: FL; JST_XH_B4B-XH-AM_1x04_P2.50mm_Vertical
J3: FR; JST_XH_B4B-XH-AM_1x04_P2.50mm_Vertical
J4: RL; JST_XH_B4B-XH-AM_1x04_P2.50mm_Vertical
J5: RR; JST_XH_B4B-XH-AM_1x04_P2.50mm_Vertical
J6: Barrel_Jack_Switch_Pin3Ring; BarrelJack_Horizontal
J7: USB_C_Receptacle_USB2.0_16P; USB_C_Receptacle_HRO_TYPE-C-31-M-12; Manufacturer_Part_Number USB4105-GF-A-060; LCSC C165948
J8: OLED; OLED_0.96
JP2: SolderJumper_2_Bridged; SolderJumper-2_P1.3mm_Bridged_Pad1.0x1.5mm; Manufacturer_Part_Number N/A
R1: 1k; R_0603_1608Metric; Manufacturer_Part_Number RC0402FR-071KL; LCSC C21190
R2: 10k; R_0603_1608Metric; Manufacturer_Part_Number AC0402FR-7D100KL; LCSC C25804
R3, R4: 5k1; R_0603_1608Metric; Manufacturer_Part_Number RC0402FR-071KL; LCSC C23186
R5, R16: 4.7k; R_0603_1608Metric; Manufacturer_Part_Number RC0402FR-074K7L; LCSC C23162
R13: 330; R_0603_1608Metric; Manufacturer_Part_Number CR0402AFX-1001GAS; LCSC C23138
R28: 680; R_0603_1608Metric; Manufacturer_Part_Number AC0402FR-7D2K2L; LCSC C23228
R30: 2k; R_0603_1608Metric; Manufacturer_Part_Number CR0402-FX-5101GLF; LCSC C22975
SW1: SW_SPST; SW_SPST_TS-1088-xR025; LCSC C720477
U1: MPU-6050; QFN-24-1EP_4x4mm_P0.5mm; LCSC C24112
U2: STM32F103C8T6; LQFP-48_7x7mm_P0.5mm; Operating Voltage Range 2V~3.6V; Low Voltage Detection T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 2V~3.6V; Part STM32F103C8T6; LCSC C8734
U6, U7, U8, U9: DRV8848; TSSOP-16-1EP_4.4x5mm_P0.65mm; LCSC C131079
X1: X50328MSB2GI; CRYSTAL-SMD_L5.0-W3.2; Frequency Tolerance ±10ppm; Part X50328MSB2GI; LCSC C115962

Connections:
+3.3V: C5.2, C6.2, C7.2, C8.2, C9.2, J1.1 (VTref), J8.2, R1.1, R5.1, R13.1, R16.1, U1.8 (VLOGIC), U1.13 (VDD), U2.1 (VBAT), U2.9 (VDDA), U2.24 (VDD), U2.36 (VDD), U2.48 (VDD), U6.11 (VREF), U7.11 (VREF), U8.11 (VREF), U9.11 (VREF); also elsewhere on the board
+5V: JP2.2 (B), R28.1; also elsewhere on the board
+12V: J6.1, R30.1, U6.12 (VM), U7.12 (VM), U8.12 (VM), U9.12 (VM); also elsewhere on the board
/AIN1_FL: U2.10 (PA0), U6.16 (AIN1)
/AIN1_FR: U2.12 (PA2), U7.16 (AIN1)
/AIN1_RL: U2.16 (PA6), U8.16 (AIN1)
/AIN1_RR: U2.18 (PB0), U9.16 (AIN1)
/AIN2_FL: U2.14 (PA4), U6.15 (AIN2)
/AIN2_FR: U2.27 (PB14), U7.15 (AIN2)
/AIN2_RL: U2.20 (PB2), U8.15 (AIN2)
/AIN2_RR: U2.22 (PB11), U9.15 (AIN2)
/AOUT1_FL: J2.4, U6.2 (AOUT1)
/AOUT1_FR: J3.4, U7.2 (AOUT1)
/AOUT1_RL: J4.4, U8.2 (AOUT1)
/AOUT1_RR: J5.4, U9.2 (AOUT1)
/AOUT2_FL: J2.3, U6.4 (AOUT2)
/AOUT2_FR: J3.3, U7.4 (AOUT2)
/AOUT2_RL: J4.3, U8.4 (AOUT2)
/AOUT2_RR: J5.3, U9.4 (AOUT2)
/BIN1_FL: U2.11 (PA1), U6.9 (BIN1)
/BIN1_FR: U2.13 (PA3), U7.9 (BIN1)
/BIN1_RL: U2.17 (PA7), U8.9 (BIN1)
/BIN1_RR: U2.19 (PB1), U9.9 (BIN1)
/BIN2_FL: U2.15 (PA5), U6.10 (BIN2)
/BIN2_FR: U2.26 (PB13), U7.10 (BIN2)
/BIN2_RL: U2.21 (PB10), U8.10 (BIN2)
/BIN2_RR: U2.25 (PB12), U9.10 (BIN2)
/BOUT1_FL: J2.2, U6.7 (BOUT1)
/BOUT1_FR: J3.2, U7.7 (BOUT1)
/BOUT1_RL: J4.2, U8.7 (BOUT1)
/BOUT1_RR: J5.2, U9.7 (BOUT1)
/BOUT2_FL: J2.1, U6.5 (BOUT2)
/BOUT2_FR: J3.1, U7.5 (BOUT2)
/BOUT2_RL: J4.1, U8.5 (BOUT2)
/BOUT2_RR: J5.1, U9.5 (BOUT2)
/CAN_RX: U2.45 (PB8)
/CAN_TX: U2.46 (PB9)
/GPS_RX: U2.31 (PA10)
/GPS_TX: U2.30 (PA9)
/IMU_INT: U1.12 (INT), U2.41 (PB5)
/SCL: J8.4, R5.2, U1.23 (SCL), U2.42 (PB6)
/SDA: J8.3, R16.2, U1.24 (SDA), U2.43 (PB7)
/SWCLK/TCK: J1.4 (SWCLK/TCK), U2.37 (PA14)
/SWDIO/TMS: J1.2 (SWDIO/TMS), U2.34 (PA13)
/SWO/TDO: J1.6 (SWO/TDO), U2.39 (PB3)
/USB+: J7.A6 (D+), J7.B6 (D+), U2.33 (PA12)
/USB-: J7.A7 (D-), J7.B7 (D-), U2.32 (PA11)
/~FAULT_FL: U2.2 (PC13), U6.8 (~FAULT)
/~FAULT_FR: U2.29 (PA8), U7.8 (~FAULT)
/~FAULT_RL: U2.3 (PC14), U8.8 (~FAULT)
/~FAULT_RR: U2.28 (PB15), U9.8 (~FAULT)
/~SLEEP: U2.40 (PB4), U6.1 (~SLEEP), U7.1 (~SLEEP), U8.1 (~SLEEP), U9.1 (~SLEEP)
GND: C1.1, C2.1, C3.1, C5.1, C6.1, C7.1, C8.1, C9.1, C10.2, C11.1, C12.1, C13.1, C14.1, C34.2, D7.1 (K), D12.1 (K), D14.1 (K), H1.1, H2.1, H3.1, H4.1, J1.3 (GND), J1.5 (GND), J1.9 (GNDDetect), J6.2, J6.3, J7.A1 (GND), J7.A8 (SBU1), J7.A12 (GND), J7.B1 (GND), J7.B8 (SBU2), J7.B12 (GND), J7.S1 (SHIELD), J8.1, R2.1, R3.2, R4.2, SW1.2 (B), U1.1 (CLKIN), U1.9 (AD0), U1.11 (FSYNC), U1.18 (GND), U2.8 (VSSA), U2.23 (VSS), U2.35 (VSS), U2.47 (VSS), U6.13 (GND), U6.17 (GND), U7.13 (GND), U7.17 (GND), U8.13 (GND), U8.17 (GND), U9.13 (GND), U9.17 (GND); also elsewhere on the board
unnamed: D1.2, J7.A4 (VBUS), J7.A9 (VBUS), J7.B4 (VBUS), J7.B9 (VBUS)
unnamed: D7.2 (A), R13.2
unnamed: D12.2 (A), R28.2
unnamed: D14.2 (A), R30.2
unnamed: C1.2, J1.10 (~RESET), R1.2, SW1.1 (A), U2.7 (NRST)
unnamed: J7.A5 (CC1), R3.1
unnamed: J7.B5 (CC2), R4.1
unnamed: D1.1, JP2.1 (A)
unnamed: C10.1, U1.20 (CPOUT)
unnamed: C34.1, U1.10 (REGOUT)
unnamed: R2.2, U2.44 (BOOT0)
unnamed: C2.2, U2.5 (PD0), X1.2
unnamed: C3.2, U2.6 (PD1), X1.1
unnamed: C14.2, U6.14 (VINT)
unnamed: C11.2, U7.14 (VINT)
unnamed: C12.2, U8.14 (VINT)
unnamed: C13.2, U9.14 (VINT)
