irfxn-r/Active-Dampers/Combined/Active-Dampers.kicad_pcb

## KiCad design Combined/Active-Dampers.kicad_pcb (continued)

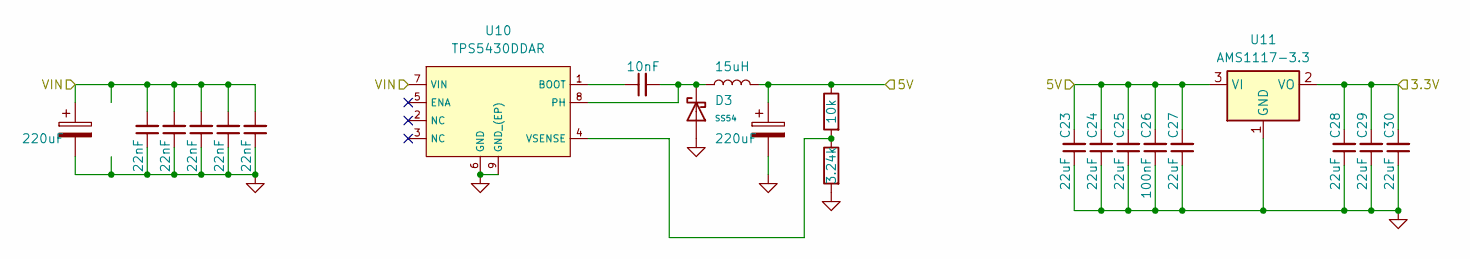
[picture p10: schematic input.kicad_sch]

Parts:
C15, C22: 220uF; CP_Radial_D8.0mm_P3.50mm
C16, C17, C18, C19, C20: 22nF; C_0603_1608Metric; Manufacturer_Part_Number CL05A106MP5NUNC; LCSC C21122
C21: 10nF; C_0603_1608Metric; Manufacturer_Part_Number GRM155R60J226ME11D; LCSC C57112
C23, C24, C25, C27, C28, C29, C30: 22uF; C_0603_1608Metric; Manufacturer_Part_Number GRM155R60J226ME11D; LCSC C59461
C26: 100nF; C_0603_1608Metric; Manufacturer_Part_Number CL05B104KO5NNNC; LCSC C14663
D3: SS54; D_SMA; Forward Voltage (Vf@If) 550mV@5A; Reverse Voltage (Vr) 40V; Part SS54; LCSC C22452
L1: 15uH; Inductor_7.3x6.6mm; Manufacturer_Part_Number SLO0630H150MTT
R7: 10k; R_0603_1608Metric; Manufacturer_Part_Number RC0402FR-0710KL; LCSC C25804
R8: 3.24k; R_0603_1608Metric; Manufacturer_Part_Number RC0402FR-0710KL; LCSC C22978
U10: TPS5430DDAR; ESOP-8_L4.9-W3.9-P1.27-LS6.0-TL-EP; Output Voltage 1.221V~32.04V; Input Voltage 5.5V~36V; Part TPS5430DDAR; LCSC C9864
U11: AMS1117-3.3; SOT-223-3_TabPin2; LCSC C6186

Connections:
+3.3V: C28.2, C29.2, C30.2, U11.2 (VO); also elsewhere on the board
+5V: C22.1, C23.2, C24.2, C25.2, C26.2, C27.2, L1.2, R7.2, U11.3 (VI); also elsewhere on the board
+12V: C15.1, C16.2, C17.2, C18.2, C19.2, C20.2, U10.7 (VIN); also elsewhere on the board
GND: C15.2, C16.1, C17.1, C18.1, C19.1, C20.1, C22.2, C23.1, C24.1, C25.1, C26.1, C27.1, C28.1, C29.1, C30.1, D3.2, R8.1, U10.6 (GND), U10.9 (GND_(EP)), U11.1 (GND); also elsewhere on the board
unnamed: C21.1, U10.1 (BOOT)
unnamed: C21.2, D3.1, L1.1, U10.8 (PH)
unnamed: R7.1, R8.2, U10.4 (VSENSE)

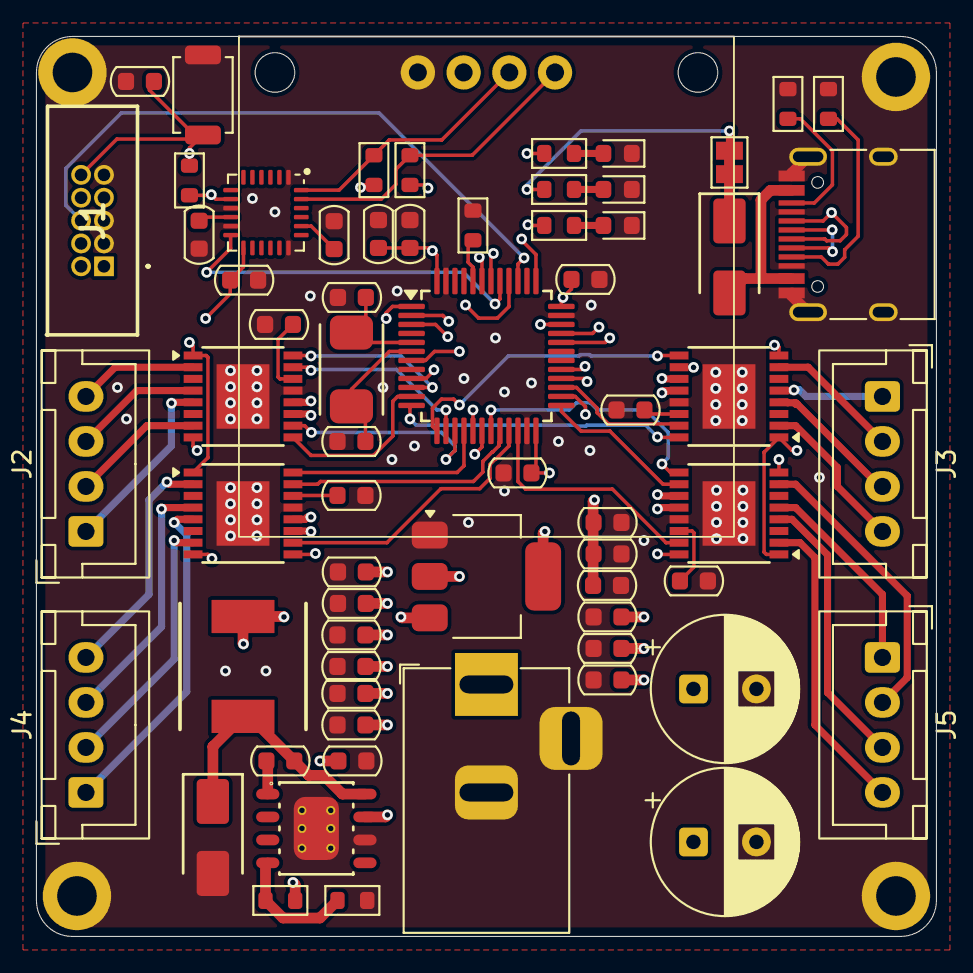
[picture p11: board Active-Dampers.kicad_pcb from above]

Board: 4 copper layers, 50.0 x 50.0 mm, 70 parts (0 on the bottom side), 69 nets.
