irfxn-r/Active-Dampers/Daughter/imu_daughter_board/imu_daughter_board.kicad_pcb

## KiCad design Daughter/imu_daughter_board/imu_daughter_board.kicad_pcb (2026-10-05)

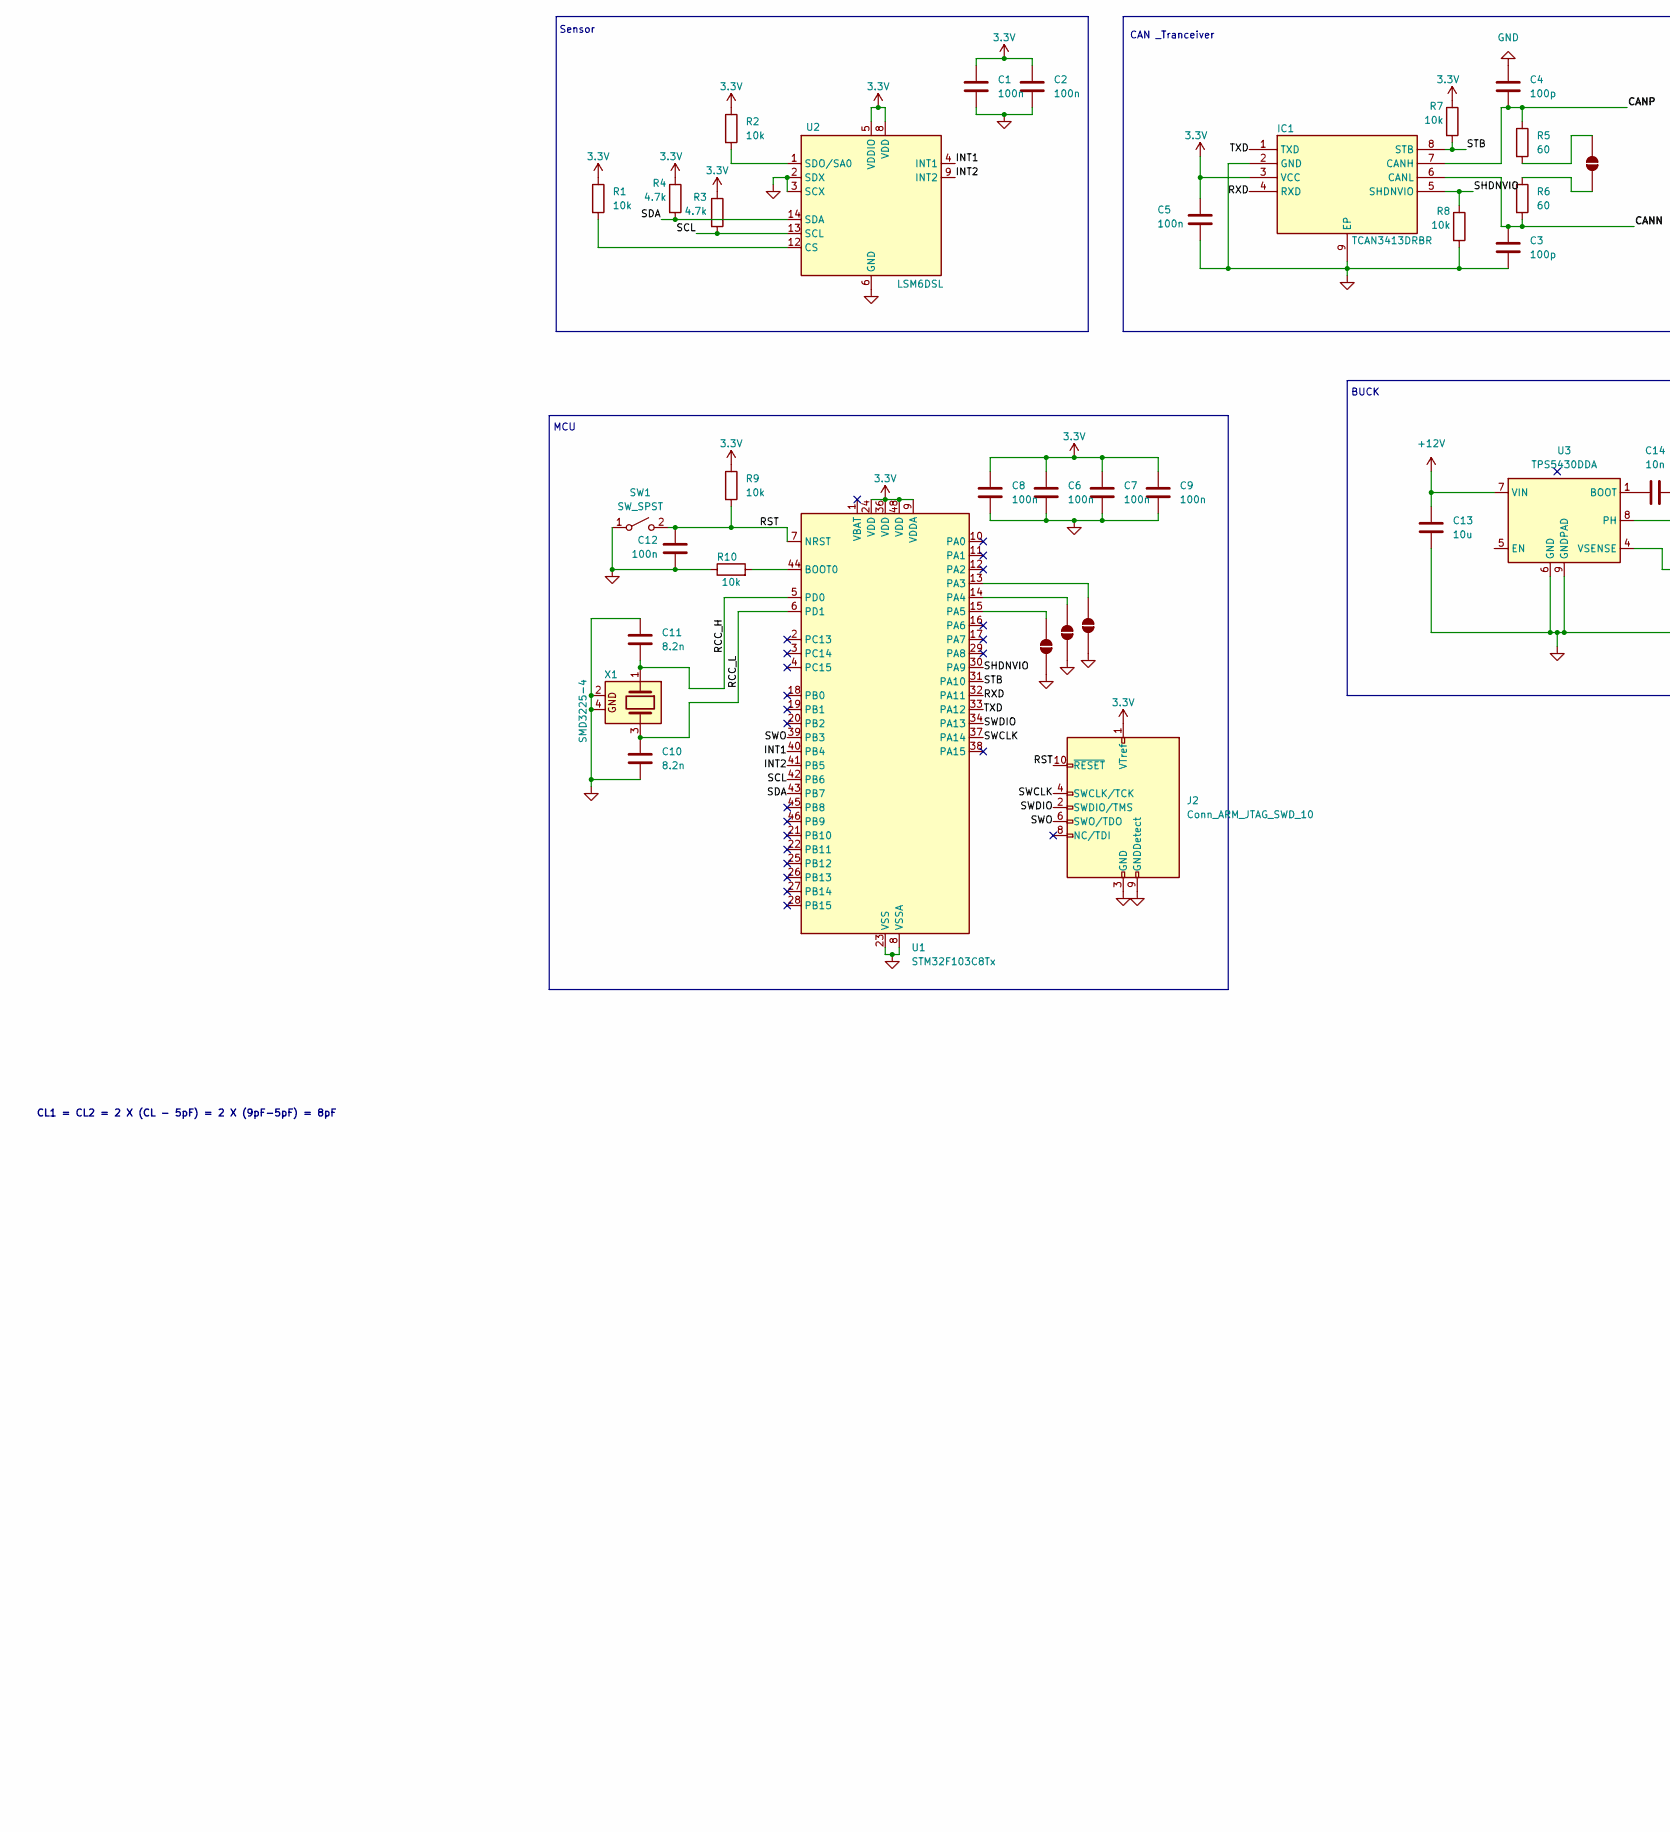
[picture p12: schematic imu_daughter_board.kicad_sch, part in row 1, column 1]

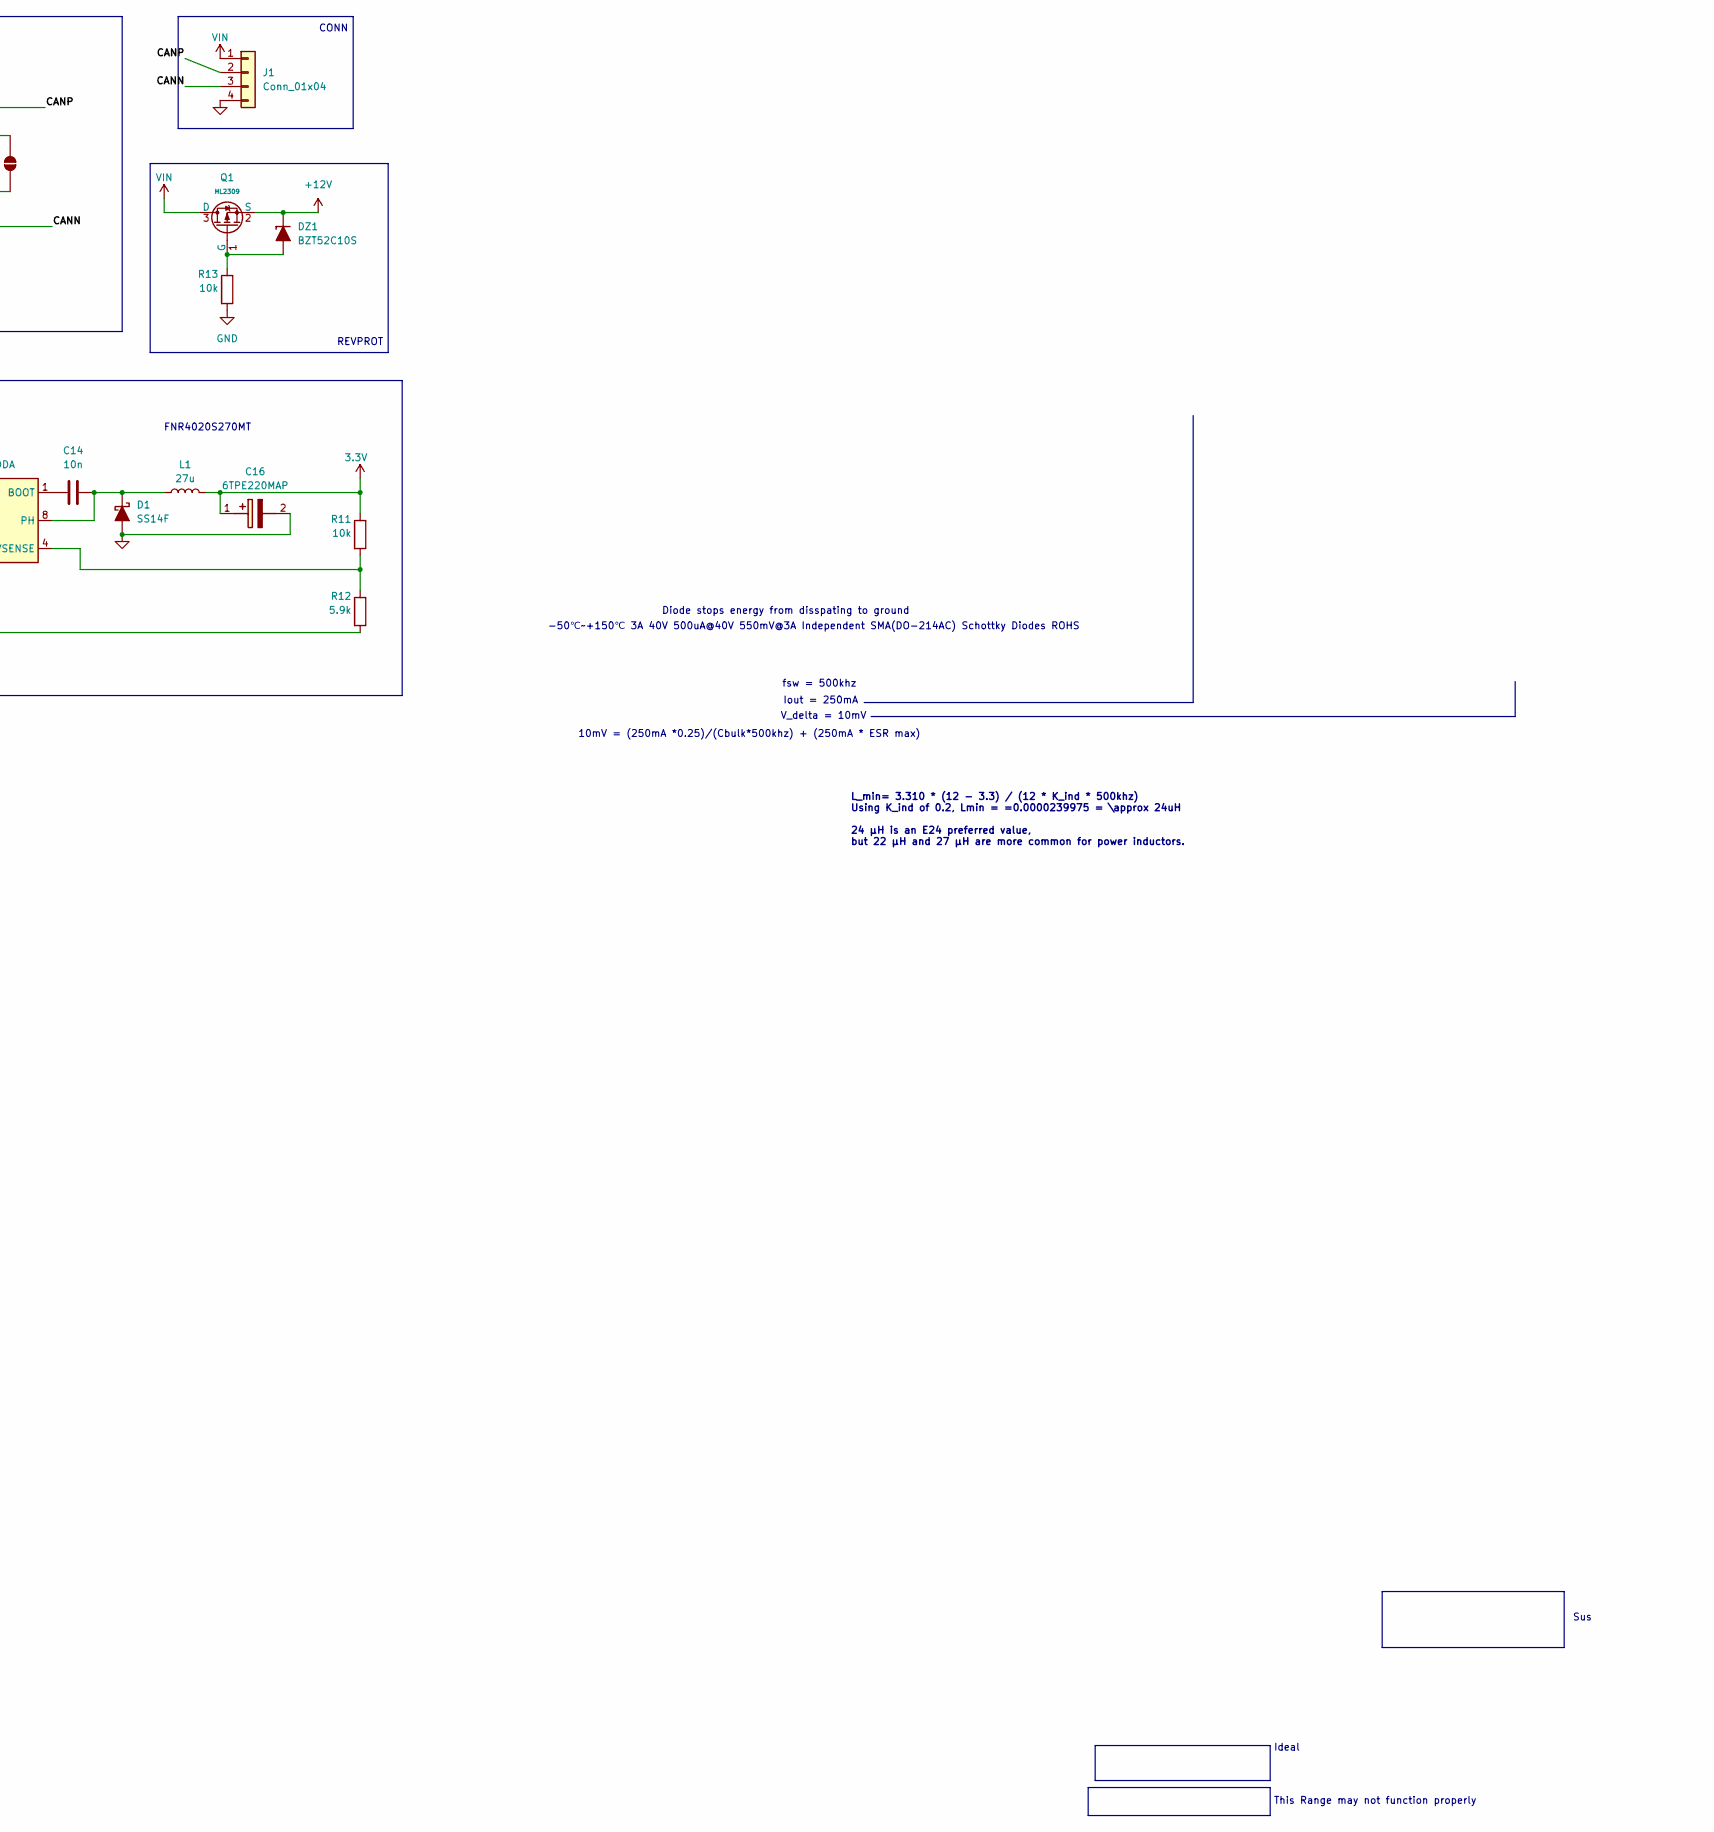
[picture p13: schematic imu_daughter_board.kicad_sch, part in row 1, column 2]

Parts:
C1, C2, C5, C6, C7, C8, C9, C12: 100n; C_0402_1005Metric
C3, C4: 100p; C_0402_1005Metric
C10, C11: 8.2n; C_0402_1005Metric
C13: 10u; C_0603_1608Metric_Pad1.05x0.95mm
C14: 10n; C_0603_1608Metric_Pad1.05x0.95mm
C16: 6TPE220MAP; 2R5TAE330MF; Mouser Part Number 667-6TPE220MAP
D1: SS14F; D_SMAFL
DZ1: BZT52C10S; D_SOD-323
IC1: TCAN3413DRBR; SON65P300X300X100-9N-D; Mouser Part Number 595-TCAN3413DRBR
J1: Conn_01x04; SolderWire-0.5sqmm_1x04_P4.6mm_D0.9mm_OD2.1mm
J2: Conn_ARM_JTAG_SWD_10; SHF10501FDTH
JP1, JP2, JP3, JP4: SolderJumper_2_Open; SolderJumper-2_P1.3mm_Open_Pad1.0x1.5mm
L1: 27u; L_Taiyo-Yuden_MD-4040
Q1: HL2309; Q_SOT-23; Part HL2309; LCSC C28646263
R1, R2, R7, R8, R9, R10: 10k; C_0402_1005Metric
R3, R4: 4.7k; C_0402_1005Metric
R5, R6: 60; R_0402_1005Metric
R11, R13: 10k; R_0603_1608Metric
R12: 5.9k; R_0603_1608Metric
SW1: SW_SPST; SW_SPST_TS-1088-xR025
U1: STM32F103C8Tx; LQFP-48_7x7mm_P0.5mm
U2: LSM6DSL; LGA-14_3x2.5mm_P0.5mm_LayoutBorder3x4y
U3: TPS5430DDA; TI_SO-PowerPAD-8_ThermalVias
X1: SMD3225-4; Crystal_SMD_3225-4Pin_3.2x2.5mm

Connections:
3.3V: C1.2, C2.1, C5.2, C6.2, C7.1, C8.2, C9.1, C16.1 (+), IC1.3 (VCC), J2.1 (VTref), L1.2, R1.1, R1.2, R2.1, R3.1, R4.1, R7.1, R9.1, R11.1, U1.9 (VDDA), U1.24 (VDD), U1.36 (VDD), U1.48 (VDD), U2.5 (VDDIO), U2.8 (VDD), U2.12 (CS)
+12V: C13.1, DZ1.1 (K), Q1.2 (S), U3.7 (VIN)
/CANN: C3.1, IC1.6 (CANL), J1.3, R6.2
/CANP: C4.2, IC1.7 (CANH), J1.2, R5.1
/INT1: U1.40 (PB4), U2.4 (INT1)
/INT2: U1.41 (PB5), U2.9 (INT2)
/RCC_H: C11.1, U1.5 (PD0), X1.1
/RCC_L: C10.2, U1.6 (PD1), X1.3
/RST: C12.2, J2.10 (~RESET), R9.2, SW1.2 (B), U1.7 (NRST)
/RXD: IC1.4 (RXD), U1.32 (PA11)
/SCL: R3.2, U1.42 (PB6), U2.13 (SCL)
/SDA: R4.2, U1.43 (PB7), U2.14 (SDA)
/SHDNVIO: IC1.5 (SHDNVIO), R8.1, U1.30 (PA9)
/STB: IC1.8 (STB), R7.2, U1.31 (PA10)
/SWCLK: J2.4 (SWCLK/TCK), U1.37 (PA14)
/SWDIO: J2.2 (SWDIO/TMS), U1.34 (PA13)
/SWO: J2.6 (SWO/TDO), U1.39 (PB3)
/TXD: IC1.1 (TXD), U1.33 (PA12)
GND: C1.1, C2.2, C3.2, C4.1, C5.1, C6.1, C7.2, C8.1, C9.2, C10.1, C11.2, C12.1, C13.2, C16.2 (-), D1.2 (A), IC1.2 (GND), IC1.9 (EP), J1.4, J2.3 (GND), J2.5 (GND), J2.9 (GNDDetect), JP2.1 (A), JP3.1 (A), JP4.1 (A), R8.2, R10.1, R12.2, R13.2, SW1.1 (A), U1.8 (VSSA), U1.23 (VSS), U1.35 (VSS), U1.47 (VSS), U2.2 (SDX), U2.3 (SCX), U2.6 (GND), U2.7 (GND), U3.6 (GND), U3.9 (GNDPAD), X1.2, X1.4
unnamed: C14.2, D1.1 (K), L1.1, U3.8 (PH)
unnamed: DZ1.2 (A), Q1.1 (G), R13.1
unnamed: JP1.1 (A), R6.1
unnamed: JP1.2 (B), R5.2
unnamed: JP2.2 (B), U1.15 (PA5)
unnamed: JP3.2 (B), U1.14 (PA4)
unnamed: JP4.2 (B), U1.13 (PA3)
unnamed: R10.2, U1.44 (BOOT0)
unnamed: R2.2, U2.1 (SDO/SA0)
unnamed: C14.1, U3.1 (BOOT)
unnamed: R11.2, R12.1, U3.4 (VSENSE)
VIN: J1.1, Q1.3 (D)

Notes on the sheet:
-50℃~+150℃ 3A 40V 500uA@40V 550mV@3A Independent SMA(DO-214AC) Schottky Diodes ROHS
This Range may not function properly
REVPROT
Sus
10mV = (250mA *0.25)/(Cbulk*500khz) + (250mA * ESR max)
CL1 = CL2 = 2 X (CL - 5pF) = 2 X (9pF-5pF) = 8pF
CONN
V_delta = 10mV
Ideal
Vpp max = 20mV
R2 = R1 * 1.221 / (3.3 - 1.221) R1 = 10kohm R2 = 10e3 * 1.221 / (3.3 - 1.221) 5873.01587302
Maybe not important yet
Sensor
BUCK
L_min= 3.310 * (12 - 3.3) / (12 * K_ind * 500khz) Using K_ind of 0.2, Lmin = =0.0000239975 = \approx 24uH 24 µH is an E24 preferred value, but 22 µH and 27 µH are more common for power inductors.
MCU
Use 5.90 kΩ, 1%-it's a standard E96 value closest to your calculated 5.873 kΩ.
fsw = 500khz
CAN _Tranceiver
FNR4020S270MT
Diode stops energy from disspating to ground
Iout = 250mA

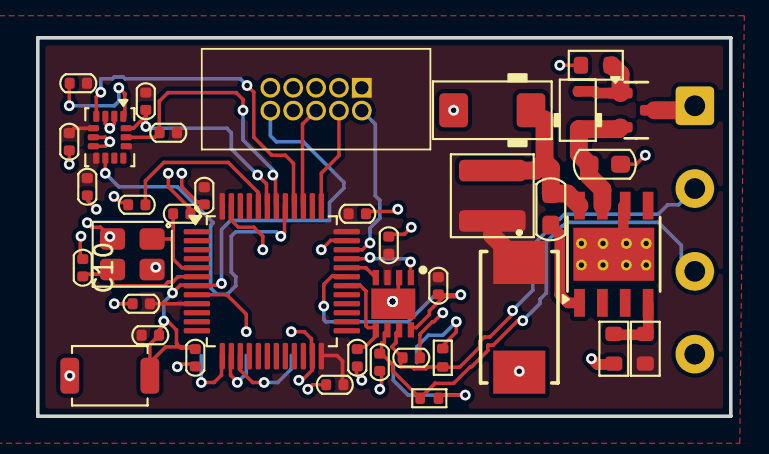
[picture p14: board imu_daughter_board.kicad_pcb from above]

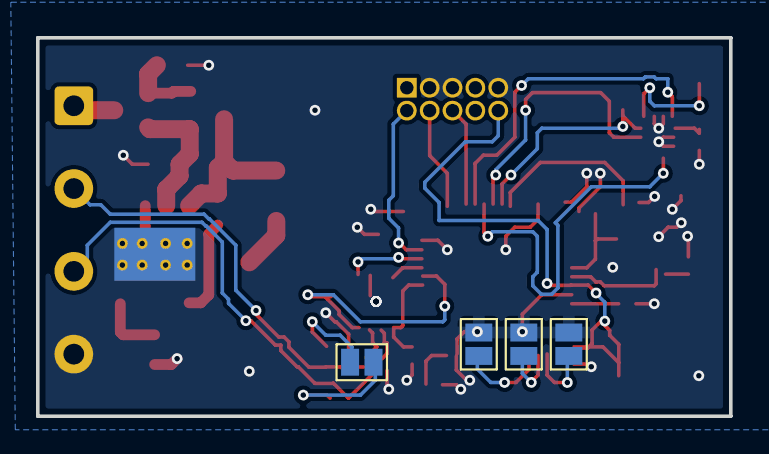
[picture p15: board imu_daughter_board.kicad_pcb from below]

Board: 2 copper layers, 38.5 x 21.0 mm, 43 parts (4 on the bottom side), 31 nets.
