irfxn-r/Active-Dampers/Combined/stm32/cubemx/cubemx.ioc

Mcu.UserName=STM32F103C8Tx
PA0-WKUP.GPIO_Label=AIN1_FL
PA0-WKUP.Signal=S_TIM2_CH1_ETR
PA1.GPIO_Label=BIN1_FL
PA1.Signal=S_TIM2_CH2
PA10.Signal=USART1_RX
PA11.Signal=USB_DM
PA12.Signal=USB_DP
PA13.Signal=SYS_JTMS-SWDIO
PA14.Signal=SYS_JTCK-SWCLK
PA2.GPIO_Label=AIN1_FR
PA2.Signal=S_TIM2_CH3
PA3.GPIO_Label=BIN1_FR
PA3.Signal=S_TIM2_CH4
PA4.GPIO_Label=AIN2_FL
PA4.Signal=GPIO_Output
PA5.Signal=GPIO_Output
PA6.Signal=S_TIM3_CH1
PA7.Signal=S_TIM3_CH2
PA9.Signal=USART1_TX
PB0.Signal=S_TIM3_CH3
PB1.Signal=S_TIM3_CH4
PB3.Signal=SYS_JTDO-TRACESWO
PB6.Signal=I2C1_SCL
PB7.Signal=I2C1_SDA
PB8.Signal=CAN_RX
PB9.Signal=CAN_TX
PD0-OSC_IN.Signal=RCC_OSC_IN
PD1-OSC_OUT.Signal=RCC_OSC_OUT
