irfxn-r/Active-Dampers/(commit log)

2026-01-12 redo design to esp32
    [Active-Dampers.kicad_pcb, Active-Dampers.kicad_sch, can.kicad_sch, input.kicad_sch]
2026-01-14 begin layout
    [Active-Dampers.kicad_pcb, Active-Dampers.kicad_sch, can.kicad_sch, input.kicad_sch]
2026-01-16 add cubemx project and redo some layour with new parts
    [Active-Dampers.kicad_pcb, Active-Dampers.kicad_sch, can.kicad_sch, input.kicad_sch]
2026-01-17 keep working on pcb
    [Active-Dampers-CuBottom.gbr, Active-Dampers-CuTop.gbr, Active-Dampers-EdgeCuts.gbr, Active-Dampers-MaskBottom.gbr, Active-Dampers-MaskTop.gbr, Active-Dampers-NPTH.drl, Active-Dampers-PTH.drl, Active-Dampers-SilkBottom.gbr]
2026-01-19 create prod files
    [Active-Dampers.kicad_pcb]
2026-07-02 finish layout on master
    [Active-Damper-Master.kicad_pcb, Active-Damper-Master.kicad_sch, Active-Damper-Slave.kicad_pcb, Active-Damper-Slave.kicad_sch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]
2026-07-10 finish prod files for master
    [Active-Damper-Master-CuBottom.gbr, Active-Damper-Master-CuTop.gbr, Active-Damper-Master-EdgeCuts.gbr, Active-Damper-Master-MaskBottom.gbr, Active-Damper-Master-MaskTop.gbr, Active-Damper-Master-NPTH.drl, Active-Damper-Master-PTH.drl, Active-Damper-Master-SilkBottom.gbr]
2026-07-14 keep working on slave
    [Active-Damper-Master.kicad_sch, Active-Damper-Slave.kicad_pcb, Active-Damper-Slave.kicad_sch]
2026-09-19 add prod files, not done
    [Active-Damper-Master-CuBottom.gbr, Active-Damper-Master-CuTop.gbr, Active-Damper-Master-EdgeCuts.gbr, Active-Damper-Master-MaskBottom.gbr, Active-Damper-Master-MaskTop.gbr, Active-Damper-Master-NPTH.drl, Active-Damper-Master-PTH.drl, Active-Damper-Master-SilkBottom.gbr]
2026-09-21 init daughter
    [imu_daughter_board.kicad_pcb, imu_daughter_board.kicad_sch]
2026-09-21 almost done schem_daughter
    [imu_daughter_board.kicad_pcb, imu_daughter_board.kicad_sch]
2026-09-27 sch done
    [imu_daughter_board.kicad_pcb, imu_daughter_board.kicad_sch, sch_data.json]
2026-09-27 make prod files, clean up CAN wiring on slave
    [Active-Damper-Master.kicad_pcb, Active-Damper-Master.kicad_sch, Active-Damper-Slave.kicad_pcb, Active-Damper-Slave.kicad_sch, input.kicad_sch]
2026-09-27 review daughter
    [imu_daughter_board.kicad_pcb, imu_daughter_board.kicad_sch]
2026-09-27 draft 1 complete
    [imu_daughter_board.kicad_pcb]
2026-10-02 needs checking
    [imu_daughter_board.kicad_pcb]
2026-10-04 done needs review, all the errors are all related to footprint or pink overlap looks good in 3d
    [imu_daughter_board.kicad_pcb, imu_daughter_board.kicad_sch, sch_data.json]
2026-10-05 ready to source
    [imu_daughter_board.kicad_pcb]
